Evan0825/feldspar/docs/design/review-decisions-20261029.md

# 月石逐页选稿记录 · 2026-10-29

来源：用户上传的确认汇总截图 `codex-clipboard-64d0b12b-cbe1-4e58-856b-c7799b330244.png`。这是直接反馈记录，不冒充服务端已提交回执。

## 已选18页

| 方案1 | 方案2 |
| --- | --- |
| p01登录、p04添加设备、p05连接网络、p06设备自检、p07月石首页、p09夜灯、p10助眠声音、p12七晚趋势、p13夜间事件、p19AI记忆、p20我的、p21AI与数据授权、p22实时状态、p23设备与家庭 | p02个性化偏好、p17今晚方案、p18对话记录、p24今晚设置 |

## 待确认6页

| 页面 | 用户意见 | 本轮处理 |
| --- | --- | --- |
| p03隐私与数据 | 保持原样或按照推荐 | 说明与读取权限分开，一次明确确认 |
| p08温和方案 | 阶段介绍太长，两套都不喜欢 | 当前阶段和真实进度优先；四阶段短标签或按需展开 |
| p11单晚睡眠 | 方案2较好，图表详情是否二级进入 | 保留简洁首屏，接通数据详情、图表、质量、体位关联和事件 |
| p14晨间反馈 | 两套需要结合 | 同屏三个短问题；逐题版支持返回和提交前汇总 |
| p15AI首页 | 需多个联动交互后判断 | 接通报告、依据、问题、建议、确认和历史演示 |
| p16AI对话 | 同上 | 支持追问、原夜晚回看、建议独立确认后返回对话 |

整体意见：未确认页面下一轮确认；页面过于模糊，须优化，不允许沿用。

## 清晰度和素材约束

- 文字、图表与控件直接渲染；每页独立导出1170×2532，不把多屏总览裁成小图后放大。
- 评审默认以390px以内展示，原尺寸放大有真实高分辨率像素。
- 所有产品大图共用 `design/assets/moonstone-system-natural-light-hd-cutout.png`，逻辑尺寸320×190；夜灯只叠加暖光效果，不改变产品图本身。
- 浏览器联动是本地设计演示，示例数据与模拟回读明确标注，不代替原生小程序或真实设备验收。
- 保留旧评审草稿键和用户选择；版本更新后不沿用旧回执。允许提交已确认部分，未选6页保持待确认。

本轮未修改小程序业务文件。下一步以待确认页面的选择推进原生实现，既定18页选稿方向不重开选择。

## 后续执行授权与定稿

用户随后明确要求：剩余6页按推荐完成，直接执行、不再询问。以上「待确认」为历史状态；本次采用 p03一次隐私确认、p08当前阶段优先且完整阶段折叠、p11简洁首屏与二级数据、p14同屏短表单、p15来源明确的精简AI入口、p16可追问并独立应用建议。

原生业务已更新上述6页及必要的数据详情、建议依据折叠；新增 `pages/report-detail/index`。浏览器完整推荐方案只提供一套组合，不再要求逐页选择。来源记录、AI授权、偏好限制、设备确认与历史保存沿用既有服务边界。旧评审草稿和回执不被伪造成新的提交。
