Evan0825/feldspar/docs/design/ui-assets.md

# 月石界面素材

- `moonstone-ui-v1-sleep-home.png`、`moonstone-ui-v1-sleep-detail.png` 为 [现行设计规范](../ui-style-preferences.md) 的方案 5 定稿参考图，采用同一晚的示例数据，独立导出 1170×2532。
- `moonstone-ui-approved-20261028.png` 为上一轮选稿的四屏设计存档。
- 原生 `images/ui/` 的 Lucide 图标与 `images/ai-ui/` 图标由项目使用的 `lucide-react` 1.37.0 栅格化，遵循所附 ISC 许可。`images/ui/` 也包含 Material Icons，Apache-2.0 许可随目录提供。
- 设备主图、紧凑设备图和夜灯缩略图：复用本项目已有设备图片，没有新增第三方照片。
- 原生实屏来自微信开发者工具，单独保存到验证目录；不得把生成稿当作硬件运行效果证据。
