Evan0825/feldspar/COLLABORATION.md

# 共同维护

仓库地址：https://github.com/Evan0825/feldspar ，私有。后续可迁移至免费组织 feldspar-sleep。每人使用自己的 GitHub 账号；由仓库负责人邀请指定好友共同维护，不共享账号或密钥。协作者邀请对象为 Fu99966；邀请是否接受以 GitHub 显示为准。

1. 克隆仓库，按 README 安装依赖并运行离线检查。
2. 每个修改使用独立分支，通过 Pull Request 说明变更与验证结果；保留 review 讨论。
3. 凭据、设备密钥、私人录音与睡眠数据保留本地；使用配置模板接入各自测试环境。
4. 固件协议/输出改动需对应构建及实机验收；未完成数据评估和物理标定前保持自动干预关闭。

GitHub Free 私有仓库可使用 Issue/PR 协作；是否强制审核或保护分支以套餐支持为准，不把尚未配置的保护规则描述为已经启用。
