Evan0825/feldspar/docs/materials/snoring-model-training-report.html

本报告记录 2026 年 9 月的 v5 鼾声模型研究。模型尚未集成到 V6 公开固件。报告原创内容采用 CC BY-NC 4.0 (https://creativecommons.org/licenses/by-nc/4.0/deed.zh-hans)，非商业教学与科研可免费使用，商用须另行授权。

SnoozMate · 酣眠 · 端侧鼾声识别模型 · 训练与验证报告 · 2026-09-05

# 床头主机上的鼾声识别模型：从数据到可发布固件

酣眠的床头主机（ESP32-S3，双麦克风）需要在本地实时识别连续鼾声、判断鼾声来自床的哪一侧，并把结构化事件而不是录音交给云端。本报告说明这个模型是怎样训练出来的：数据如何清洗与隔离、标签如何核验、网络如何选型与校准、结果如何在测试集、整夜流式基准与方向仿真中验证，以及模型如何带着完整的可追溯性交付到固件。

床头柜上的月石卧舱亮着琥珀夜灯，用户在床上熟睡

交付物int8 模型 34,336 B · C 参考实现 · 模型卡

代码v5/ Python 包 · esp32_firmware/v5/ · 130 项测试

结果测试半 AUC 0.998 · 跨集合 AUC 0.80

代码仓库snoring-ml-training · v5 流水线

## 1目标与交付概览

产品逻辑是先正确识别，再正确归属，最后才是可停止的渐进干预：端侧运行一个小型蒸馏模型加多模态规则，安全由确定性状态机裁决，云端只做跨夜总结。因此训练工作的目标不是"一个准确率数字"，而是一条能烧进 ESP32-S3、能连续运行一整夜、能说明自己有多可信的识别链路。下表列出产品需要的每一项能力与对应的实现。

产品需求 | 实现方式 | 状态
0.5–1 米床头鼾声初筛，端侧蒸馏模型（ESP32-S3） | 冻结特征规格 v1，25,745 参数卷积网络，int8 TFLite 34 KB，C 特征提取与黄金向量逐值对齐 | 已实现
连续、周期性鼾声才算数，排除偶发声响 | 整数节拍状态机：至少 3 次爆发、周期 1.5–7 s、10 s 确认窗；Python 与 C 双实现，702 拍零差异 | 已实现
鼾声停止即时撤出，可记录响应时间 | 活跃标志逐拍输出，15 s 无活动结束片段并给出时长、均值置信度与声级 | 已实现
声源方向：只提醒打鼾者一侧 | 双麦 GCC-PHAT，带限 60–3000 Hz，噪声底跟踪，片段级直方图聚合；仿真在 0.06 m 麦距、≤1 m、SNR ≥5 dB 时侧别准确率 ≥0.94 | 已实现
两个人都可能打鼾时不自动干预 | 双方判定规则：两侧有效帧都超过比例阈值时返回 both，交由固件转为只记录 | 已实现
在床、体动、翻身（毫米波雷达） | 边缘事件结构预留 radar_presence / radar_motion / radar_breath_rate 字段；云端载荷只在雷达确有观测时携带，不凭空生成"在床" | 字段预留，无数据
仰卧 / 侧卧趋势 | 需要声学体位数据集（SSBPR，需向作者申请）；本轮未实现 | 未实现
渐进提醒、冷却、温度、次数等安全上限 | 属于固件确定性状态机与云端 SAFETY_LIMITS；本项目只输出"确认中且活跃"的信号，不触碰执行权 | 范围外
记录结果，上传的是事件而不是整夜录音 | edge_event_v1 事件结构，转换为云端 EventIn；备注 JSON 不超过 1000 字符，无原始音频 | 已实现
七晚学习、晨报、伴侣净收益 | 云端仓库已有 bandit 参数调优与晨间解读；本项目提供其输入事件 | 云端已有
演示与评估中模拟数据必须与真实数据可区分 | 模型版本禁止含 simulator / demo / mock；模型卡区分测试集、跨集合与合成基准，并记录每一次测试集重置的原因 | 已实现
用真实床头的自录数据持续改进模型 | 床头采集脚本 + 标注模板 + 微调脚本；候选模型通过 import-candidate 与 final --run 走同一套校验与校准 | 已实现，待数据

一句话结论。识别链路已经完整：麦克风窗口进来，1 秒后给出概率，状态机把概率变成"连续鼾声片段"，方向模块给出左右，事件按云端格式上传。链路里每一个数字都能追溯到具体的数据划分与模型哈希。真正的短板不在代码而在数据：可用的、经核验的真实鼾声只有约 550 个训练窗口，因此模型在陌生录音环境上的召回率明显低于同源测试集，下文会用数据说明这一点。

## 2端侧系统结构

系统分为三层：实时判断在本地，长期学习在云端，安全交给确定性状态机。本项目实现的是本地层里"听"的那一半，并把结果以事件形式交给云端层。图 1 是月石主机里从麦克风到事件的数据流；灰色部分是固件与云端已有或待实现的模块。

图 1 端侧识别链路。本项目交付的是白色节点：特征提取、模型、片段状态机、方向判定与事件结构。安全状态机与振动片控制留在固件，云端只收到事件。

月石卧舱、手机小程序与枕下定向振动片

训练侧对应的流水线如图 2。它刻意做成一条只能按顺序走、每一步都会拒绝错误输入的链：清单确定数据划分，教师模型核验标签，训练只在训练与验证集上选型，校准集单独决定阈值，测试集只由导出器读取一次，模型卡最后把所有报告的哈希对上。

图 2 训练与发布流水线。每一步的产物都记录上一步产物的 SHA-256；任何一步的输入若不属于当前发布，后续命令直接拒绝。

## 3数据：来源、去重、隔离划分

训练目录里有五组数据：WHLTalent 的"鼾声 / 环境"批次，Kaggle 上的两份鼾声集（adrianagaler 与 jibran），ESC-50 环境声（含 40 段打鼾），以及 MS-SNSD 的房间噪声。全部重采样到 16 kHz，按来源规则切成 1 秒窗口：鼾声文件取能量峰附近的窗口，环境文件取最响处与随机处各一个，一共解码 12,874 个窗口。

切片之后先做两层去重。逐窗口 MD5 找出 14 个完全相同的波形；再用特征余弦相似度 ≥0.98 聚出 766 个近重复簇。最重要的发现是：adrianagaler 与 jibran 有 745 个簇互相重叠，它们其实是同一份数据的两个副本。上一代 v4 把两者随机混进训练与测试，97.3% 的准确率就是这样被抬高的。

v5 的划分规则因此以"簇"和"录音组"为最小单位，任何一组只能落在一个分区：

- train：训练；val：只用于选型；calib：只用于定阈值；
- test：Kaggle 按簇对半切出的那一半，只有导出器读，且只读一次；
- bench：WHLTalent 批次 000002 的一半录音与两成 MS-SNSD 噪声，只给整夜基准与方向仿真用；
- drop：因去重、分区冲突或审计被剔除的窗口，理由逐条写入 drop_provenance.json。

trainvalcalibtest（只读一次）benchdrop

图 3 各来源窗口的最终去向（来自 manifest_report.md）。Kaggle 两份副本各自一半进入只读测试集；WHLTalent 的"鼾声"批次绝大部分被审计剔除，原因见第 4 节。

划分完成后还有一组不变量检查会让构建直接失败：同一录音组或同一近重复簇跨分区、测试集与训练集共享簇、任一分区样本数低于配置下限（如训练正样本 ≥400、校准负样本 ≥300）。生成的数据代先写到暂存目录，全部检查通过后再整体替换，回滚时连没有备份的新文件也会删除。

## 4教师审计：为什么要先质疑标签

第一次训练的验证 AUC 只有 0.74，排查后发现问题不在模型而在标签。用 YAMNet（Google 的 521 类音频事件模型）给每个非测试窗口打分，把"打鼾 + 喷鼻息"两类概率加起来看，WHLTalent 批次 000000 的"鼾声"窗口中只有 9% 被听成鼾声；这些录音是 −55 dBFS 的低频隆隆声，60 Hz 以下能量占主导。用它们训练的模型在真正可听的批次 000002 上 AUC 只有 0.15–0.34，也就是反向迁移。

于是把教师审计做成流水线里不可跳过的一步：概率低于 0.1 的正样本按"未核验"剔除，概率高于 0.5 的负样本按"混入鼾声"剔除；训练命令若发现清单没有经过审计会直接报错。审计只作用于训练、验证、校准与基准分区，测试集从不打分。

图 4 审计剔除的窗口数（按理由与来源）。批次 000000 的 1,844 个"鼾声"窗口被整体判为不可信；Kaggle 两份副本各剔除约 80 个，ESC-50 的打鼾片段也有 35 个不含可辨鼾声。审计后剩下 551 个经核验的训练正样本。

教师文件本身也被纳入追溯：teacher.csv 每行带窗口 MD5，teacher_meta.json 记录缓存指纹、教师标识与阈值；审计时若指纹或任一 MD5 对不上就拒绝应用，训练前再核对一次审计时记录的文件哈希。这样教师分数永远不会被套用到另一批音频上。

## 5特征规格与学生网络

端侧模型能不能用，首先取决于训练时的特征和固件里算出来的特征是不是同一个东西。v5 把特征规格冻结为版本 1，Python 参考实现与 C 实现共用同一份常数头文件与同一组黄金向量：

输入

16 kHz，1 秒窗口（16,000 个 int16 样本），流式每 8,000 样本推进一次

频谱

512 点 FFT，帧移 256，周期性 Hann 窗，得到 61 帧

滤波器组

30 个 HTK mel 三角滤波器，40–6000 Hz

压缩

L = 10·log10(mel + 1e-10)；X = clip((L − mean(L)) / 40, −1, 1)，逐窗去均值使模型对增益不敏感

量化

按转换器给出的 scale / zero-point 映射到 int8（本次为 0.007843，−1）

图 5a 一个经核验的训练鼾声窗口（Kaggle 训练半）的 61 × 30 特征图。横轴为时间帧，纵轴为 mel 频带，低频带的周期性能量团是鼾声的典型形态。

图 5b 一个 MS-SNSD 房间噪声窗口的特征图，能量在时间上平坦、在频率上分散。

学生网络刻意很小：三层 3×3 卷积（16 / 32 / 64 通道，各带 BatchNorm、ReLU 与 2×2 最大池化），全局平均池化，32 维全连接，输出一个 logit。共 25,745 个参数，量化后 34,336 字节，算子只有 CONV_2D、MAX_POOL_2D、MEAN、FULLY_CONNECTED、LOGISTIC 五种，激活区估计 60.6 KB。这个规模在 ESP32-S3 上每 0.5 秒推理一次绰绰有余。

图 6 学生网络结构。宽度 2.0 的变体把每层通道数翻倍（101,665 参数），用于选型对比。

训练时的增强直接对应床头场景：用镜像法生成的房间冲激响应（按直达声峰值归一化）模拟 0.5–1.5 米距离；从 MS-SNSD 与 ESC-50 训练负样本中抽噪声按信噪比混合；再加频谱倾斜、时移、增益与 SpecAugment 遮挡。每个样本的随机数由 (种子, 轮次, 批次, 槽位) 决定，任何一次训练都能逐样本复现。

## 6训练矩阵与选型

选型只看验证集，且必须跑完固定的四组实验：硬标签 / 知识蒸馏 × 宽度 1.0 / 2.0。蒸馏把 YAMNet 的分数经 Platt 校准后作为软目标，与硬标签按 0.5 混合。选型规则写在配置里：在 AUC 距最优 0.005 以内且 2% 误报率下召回距最优 2 个点以内的实验中取参数最少者；若没有实验同时满足，则在 AUC 近最优者中取召回最高者。

图 7 四组实验在验证集上的 AUC 与 2% 误报率下的召回。hard_w1 是唯一 AUC 落在最优 0.005 以内的实验，被选中；蒸馏与加宽都没有带来收益，说明瓶颈在数据量而不是模型容量。

每次训练都把清单哈希、验证集样本哈希、模型文件哈希与审计状态写进 metrics.json。选型命令会核对四组实验的名称与 (蒸馏, 宽度) 配置一一对应、验证集完全相同、模型文件未被改动，否则拒绝选型。

## 7阈值校准：把误报率钉在 1%

产品对误触发的容忍度很低，因为每一次误触发都是一次对伴侣的打扰。阈值 τ 不由验证集决定，而是在独立的校准集上按"负样本误报率 ≤1%"直接推导：取排序后允许越过的负样本顺序统计量，τ 是严格高于它的最小 float32 值。固件比较的是 float32 概率，因此 τ 必须本身就是 float32 可精确表示的数，头文件用 9 位有效数字输出，与 JSON、指标、基准共用同一个值。

图 8 校准集上的模型分数分布（1,013 个负样本，17 个正样本）与最终阈值 τ = 0.80605。负样本中恰有 10 个越过 τ（0.99%，Clopper-Pearson 95% 上界 1.67%）；正样本仅 17 个，召回 9/17，这也是该阈值偏保守的原因。

若校准负样本不足 300 个、没有阈值能满足误报率目标、或阈值下没有任何正样本通过，校准会直接失败并拒绝部署，而不是退回某个默认值。

## 8测试集只读一次：结果与鲁棒性

测试集是 Kaggle 按簇切出的另一半，998 个窗口，其中 514 个鼾声。它被设计成"只有导出器能读，而且一个模型只能读一次"：导出时先在 test_consumption.json 里登记模型、清单、τ 与评估包每个文件的哈希，再做评估；之后同一模型重复导出直接复用评估包，换模型、换清单、换 τ 都会被拒绝。要再评估必须执行带理由的重置命令，理由写入台账并印在模型卡上。本次发布的台账里有两条记录：一次是修复导出与增强代码后的重置，一次是把 τ 改为 float32 精确值后的重置。

模型路径 | AUC | 召回 @2% 误报 | 精确率 @τ | 召回 @τ | 误报率 @τ
float（训练模型） | 0.9978 | 0.984 | 0.996 | 0.961 | 0.004
int8（部署路径） | 0.9977 | 0.984 | 0.996 | 0.963 | 0.004

int8 与 float 的一致性门禁：AUC 差 0.0001（上限 0.005），逐窗决策一致率 99.9%（下限 99%），概率最大偏差 0.028（上限 0.05）。三项任一不满足，导出失败。

召回 @τ召回 @2% 误报

图 9 测试集上的鲁棒性扫描：叠加 MS-SNSD 噪声到不同信噪比，或卷积 0.5 / 1.0 / 1.5 米的房间冲激响应。柱上数字为该条件下的 AUC。信噪比降到 5 dB 时阈值下召回降到 0.79，1.5 米时降到 0.70，说明距离和噪声是端侧部署的主要敏感因素。

同源测试集不等于真实床头。测试半与训练半来自同一批 Kaggle 录音，AUC 0.998 说明模型学会了这批录音里的鼾声，不说明它见过所有鼾声。把同一个模型放到从未参与训练的 WHLTalent 批次 000002 上：验证材料 AUC 0.805、阈值下召回 0.19；基准材料 AUC 0.793、召回 0.12。这一差距是本次交付最重要的事实，第 15 节讨论怎么补。

## 9一晚闭环：连续鼾声状态机

只有持续、周期性的鼾声才应触发提醒，偶发声响要被排除；鼾声一停，提醒必须立即撤出。这两条都由一个整数节拍的状态机实现，节拍 500 ms，与模型推理同频。状态机只消费概率与声级，不做任何浮点累加以外的运算，因此 Python 参考与 C 实现可以逐拍对齐。

图 10 片段状态机。"活跃"是 6 秒保持窗内的最大概率是否越过 τ，供固件在确认期间驱动振动；"爆发"是连续命中的起点，周期性由爆发间隔的下中位数判断。

01

#### 持续感知

每 0.5 s 一个概率。低于 τ 的窗口不产生任何状态变化，偶发声响最多让状态短暂进入 ACTIVE。

02

#### 交叉确认（本项目的部分）

至少三次爆发、间隔落在人的呼吸周期内（1.5–7 s）、累计活跃达到 10 s，才进入 CONFIRMED。固件在此基础上再叠加在床与体位条件。

03

#### 渐进提醒

状态机只提供"确认中且活跃"的布尔量，强度、次数与冷却由固件安全状态机裁决。

04

#### 即时停止

活跃标志随最近 6 s 的概率变化，鼾声停止后 6 s 内清零；片段在 15 s 无活跃后收尾，避免呼吸间歇被切成多个片段。

05

#### 记录结果

片段结束输出起止拍、时长、均值置信度、爆发数、平均声级与片段编号，供事件结构与云端摘要使用。

为了衡量整条链路而不只是单个窗口，构建了合成整夜基准：以 bench 分区的 MS-SNSD 噪声作床，随机插入 bench 分区的鼾声片段与非鼾声干扰音，按 0 / 5 / 10 / 20 dB 生成 20 个一小时的夜晚，事件与真值一对一匹配。

floatint8（部署路径）

图 11 合成整夜基准。左：被状态机确认的鼾声片段比例；右：每小时误确认次数。int8 与 float 逐拍决策一致率 99.96%。片段确认率偏低（4%–29%）直接对应第 8 节中跨集合召回率 0.12–0.19 的事实：鼾声素材来自从未训练过的 WHLTalent 批次 000002。

## 10声源方向：只提醒打鼾者一侧

共睡模式的前提是知道鼾声来自床的哪一侧。月石有两只麦克风，实现采用 GCC-PHAT（相位变换广义互相关）：对每帧 512 点做 FFT，取右麦与左麦共轭乘积并做幅度归一，只保留 60–3000 Hz，逆变换后在 ±最大时延（麦距 0.06 m 对应 ±4 个样本）内找峰，并用抛物线插值得到亚样本时延。正时延表示声音先到左麦，即声源在左侧。

三条规则决定一帧是否可信：峰值必须至少是其余所有时延处最大相关值的 1.5 倍；带内能量至少占全帧的 5%（否则是带外噪声）；帧声级必须高于自适应噪声底 6 dB，噪声底对安静帧快速下降、对不相干的响帧缓慢上升、对相干帧从不上升。可信帧的时延进入 0.01 样本分辨率的直方图，片段结束时取下中位数得到方向，左右计数比给出置信度。片段可以无限长，内存固定。

图 12 pyroomacoustics 仿真：在 4 m × 3.5 m 房间中把 bench 分区的鼾声放在床两侧不同距离与方位，每格 50 次试验，格内数字为侧别判定准确率。产品默认麦距 0.06 m（高亮行）在 ≤1 m、SNR ≥5 dB 时准确率 0.94–1.00；1.5 m 且 0 dB 时降到 0.66，此时 32% 的片段被判为"未知"而不是猜错。

当左右两侧的可信帧都超过设定比例时，片段被标为 both，对应产品规则：两个人都可能打鼾时，第一版不自动干预，只记录并提示分别建立单人基线。C 实现提供 int16 入口（doa_gcc_phat_i16、doa_tracker_frame_i16）和每个片段开始时调用的重置函数：重置清空投票但保留噪声底，主机测试用 5,500 帧的长片段与镜像片段验证了这一点。

## 11事件而不是录音：云端载荷

设计原则是上传事件，而不是整夜录音。端侧事件结构 edge_event_v1 包含时间戳、鼾声概率、状态机状态、片段编号、方向与置信度、声级，以及为雷达预留的在床、体动、呼吸率字段；温度门控与振动等级字段用于日志回盘。转换到云端 EventIn 时：

{
  "device_id": "moonstone_01", "timestamp": 1757000000,
  "event_type": "snore_detected",
  "snore_duration_sec": 42.5,          // 片段时长
  "snore_confidence": 0.87,            // 片段内命中窗口的平均概率
  "in_bed": true,                      // 仅当雷达确有观测时才出现
  "body_motion_level": 0.3,            // 同上；没有雷达时两个字段都省略
  "model_version": "cnn_v5_int8",      // 禁止含 simulator / demo / mock
  "note": "{\"side\":\"left\",\"lag_ms\":0.12,\"doa_conf\":0.8,\"n_bursts\":11,\"level_dbfs\":-38.2}"
}

备注 JSON 不超过云端限制的 1000 字符；模型版本若含模拟数据的标记会在转换时抛错。云端据此计算夜间摘要，晨报把"哪一侧、持续多久、多少次"讲给两个人听。

## 12导出、发布门禁与可追溯性

导出命令做的事情很多，但原则只有一条：任何门禁失败，交付目录一个字节都不变。转换、评估与头文件生成都在暂存目录完成，全部通过后与固件头文件目录一起原子替换，失败则回滚到上一发布。

图 13 发布门禁顺序。测试集的读取发生在门禁链中间，读取前已确认模型与阈值属于当前清单。

模型卡是最后一道校验。它要求基准与方向报告的绑定信息（模型、TFLite、清单哈希，τ，状态机参数，基准夜数与信噪比，方向扫描的麦距、距离、试验次数）与本次导出完全一致，用生成器自己的渲染函数重新生成 Markdown 并逐字节比对，再从逐夜记录重算每个汇总指标。改过一个数字的报告进不了模型卡。

产物 | 绑定到 | 拒绝条件
runs/*/metrics.json | 清单哈希、验证集哈希、模型哈希、审计状态 | 清单重建或模型文件改动后不再参与选型
deployed/threshold.json | 模型哈希、清单哈希、验证集哈希 | 导出时与当前清单不符
test_consumption.json | 模型、清单、τ、评估包每个文件的 SHA-256 | 另一模型、另一清单、另一 τ、任一文件改动
benchmark_nights.json / doa_sim.json | 模型、TFLite、清单哈希，参数集合，Markdown 内容 | 任一项与 export_info.json 不同
teacher.csv / teacher_meta.json | 缓存指纹、逐窗 MD5、审计时的文件哈希 | 指纹或 MD5 不符即不能审计，哈希不符即不能训练

## 13C 参考实现与固件对接

工作台上的月石主机拆解件、ESP32-S3 开发板、扬声器与枕下振动片

固件工程师拿到的是四个 C99 源文件和一组生成头文件：fft512.c、snore_features.c、snore_episode_fsm.c、doa_gccphat.c，以及 model_data.c（TFLite 字节数组）、model_meta.h（量化参数、τ、状态机节拍）、feature_spec.h 与 mel_filterbank.h。工作缓冲全部为静态分配，不占任务栈，约定从单一任务调用。

window (int16[16000], hop 8000) -> sf_compute -> sf_quantize(INPUT_SCALE, INPUT_ZERO_POINT)
  -> TFLM invoke -> p = (out - OUTPUT_ZERO_POINT) * OUTPUT_SCALE -> fsm_tick(p, level_dbfs)
  -> 仅当 fsm.state == FSM_CONFIRMED && fsm.active 时允许振动
stereo frame (int16[512] × 2) -> doa_tracker_frame_i16 (片段开始时先 doa_tracker_reset_episode)
  -> 片段结束 doa_tracker_episode -> side / lag_ms / conf 写入事件备注

主机端对齐测试用 Python 生成的黄金向量驱动 C 代码：

测试 | 内容 | 结果
特征 | 12 个窗口（含 −60 dBFS 静音、满幅、测试集鼾声与噪声）的 int16 → 特征 → int8 | 最大偏差 2e-5，0 失败
状态机 | 702 拍发布参数轨迹 + 284 拍容量边界轨迹（confirm + hold + 1 = 64），逐拍比对状态、活跃、事件与片段字段，并核对保留的命中集合 | 0 差异
方向 | 整数与分数时延、静音、不相干噪声、带外 5 kHz 单音、5,500 帧含换边的长片段、重置后的镜像片段；float 与 int16 入口逐帧比对 | 0 失败

需要说明的边界：桌面 C 测试证明的是数值一致性，不是 ESP32-S3 上的可运行性。固件构建仍需确认 TFLite Micro 算子解析器包含上述五种算子、实测张量区大小（估计 60.6 KB）与 Flash 占用。

## 14自录数据与个人微调

公开数据集里的鼾声与真实床头 0.5–1 米处录到的声音并不相同，第 8 节的跨集合结果说明这一差距是当前最大的误差来源。为此交付了两样东西：

- 采集脚本 v5/recording/record_session.py：以 16 kHz 立体声从床头位置连续录制，按分钟分块写 WAV，附带标注模板（片段起止、是否鼾声、哪一侧、伴侣反馈）。
- 微调脚本 v5/finetune.py：以部署模型为起点，在自录会话上小学习率微调，留出一个会话做保留集；产物标记为 cnn_v5_ft_candidate_日期 且 deployable: false。

候选模型没有捷径：train import-candidate 在当前验证集上重新评估并登记哈希，train final --run 重新在校准集上定阈值，然后必须通过第 12 节的全部门禁。"永远不在设备端做无监督反向训练"的原则在这里体现为：微调只在训练侧、只用有标注的数据、只能通过同一条发布链。

## 15诚实的结论与下一步

评价这项工作的标准应当是"先证明适用，再持续服务"。按这个标准，本次工作证明了三件事，也暴露了一件事。

- 证明了链路可以跑通并且可信：从麦克风到事件的每一步都有 Python 参考、C 实现与逐值对齐测试，每一个数字都能追溯到清单与模型哈希。
- 证明了模型足够小、足够稳：34 KB、五种算子、int8 与 float 决策一致率 99.9%，20 dB 信噪比下测试召回 0.98。
- 证明了方向判定在产品麦距下可行：0.06 m、1 m 以内、SNR ≥5 dB 时侧别准确率 ≥0.94，且拿不准时会说"未知"。
- 暴露了数据的短板：经核验的真实鼾声训练窗口只有 551 个，模型在陌生录音环境上的召回率只有 0.12–0.19，整夜基准中只有 4%–29% 的片段被确认。这不是调参能解决的问题。

### 下一步（按收益排序）

1. 用第 14 节的采集脚本在真实床头录 3–7 晚，标注后微调；这是唯一能同时改善召回与方向可信度的事。
2. 补充经核验的公开鼾声音频（如 AudioSet 打鼾类），继续通过教师审计而不是直接信任标签。
3. 雷达在床 / 体动数据到位后，把预留字段变成真正的交叉确认条件。
4. 申请 SSBPR 数据集，评估声学体位（仰卧 / 侧卧）头是否值得做。
5. 固件侧两项小修补：fsm_init 与 doa_tracker_init 增加参数范围校验；主机测试检查内存分配结果。

本报告中的全部数字取自 output/v5/deliverables/ 下的模型卡、清单报告、实验记录、整夜基准与方向仿真结果，均由发布链在同一模型哈希（c0d3ac44…）与清单哈希（e7dd580f…）上生成。趋势观察，不是医疗诊断：本模型用于识别鼾声趋势，不替代睡眠监测、OSA 诊断或临床治疗。

snoring-ml-training · branch feat/v5-edge-pipeline · pull request #1 · 2026-09-05
