Evan0825/feldspar/hardware/v4/HAPTIC.md

# SnoozMate 枕下震动模块设计规格

## 目标

在现有“精致月石 V4 顶部按键最终版”材料包中增加一套独立的枕下震动模块。该模块将白色驱动模块和硬币震动马达封装在同一个低矮、圆润的双件式外壳内，通过有线方式连接床头月石主机。不改动现有月石主机六个打印件的几何形状。

## 已知硬件与设计假设

- 驱动模块根据用户提供的标尺图按 `24 × 35 × 10 mm` 设计。
- 驱动模块两个安装孔的标称孔径为 `4.8 mm`，孔中心距为 `16 mm`。
- 驱动模块的 CAD 保留包络为 `27 × 38 × 10.8 mm`，XY 方向每侧至少留 `1.5 mm`，高度留 `0.8 mm`。
- 硬币震动马达尚无精确实测值，本版使用 `Ø13 × 5 mm` 通用仓，适配直径 `10–12 mm`、厚度不超过 `4.5 mm` 的马达。
- 马达以 `0.5–1.0 mm` 泡棉胶或硬质双面胶固定。如实物超出通用范围，不强行压入，需按实测尺寸重新生成马达仓。
- 线材或插头最宽尺寸尚未实测，本版采用合盖后形成的 `8 × 4 mm` 侧向出线口，线材在合盖前从开口放入，不要让完整插头穿过出线口。

## 方案选择

采用“驱动模块和马达同壳封装”方案。不采用驱动模块裸露安装，因为裸露模块会形成局部硬点，也更容易受到枕头反复压力和线材拉扯。不采用独立驱动小盒，以避免增加第二个硬块和中间连接线。

## 外形与打印件

新增两个可打印 STL：

1. `snoozmate_refined_v4_final_haptic_lower.stl`：枕下震动模块下壳，包含马达仓、驱动模块安装位、走线槽、防拉扯位和合盖螺丝孔。
2. `snoozmate_refined_v4_final_haptic_lid.stl`：圆润上盖，内侧带驱动模块限位面和合盖固定柱。

组装后外形包络为 `75 × 55 × 14 mm`。平面轮廓为不对称卵石形，四周连续圆润；上表面是低拱形，底面近似平面以提高震动传递效率。外部不设计裸露立柱、棱角或高于外表面的螺丝头。

下壳底部标称壁厚 `1.6 mm`，上盖最小壁厚 `1.6 mm`，内部有效高度至少 `10.8 mm`。上下壳接缝采用内外止口定位，标称单边间隙 `0.25 mm`。

## 内部布局

- 马达仓位于底板几何中心附近，马达的平面紧贴下壳底板，不在马达和底板之间放置厚软垫。
- 驱动模块沿 `75 mm` 长轴方向布置在马达仓旁，避免与马达仓及出线口重叠。
- 驱动模块上下各使用 `0.4 mm` EVA 或 TPU 缓冲片，合计 `0.8 mm` 高度余量；下垫减少模块长期直接承受震动冲击，上垫提供轻微预压。
- 驱动模块两孔按 `16 mm` 中心距排列。下壳设置两根 `Ø4.4 mm` 圆头定位柱，穿入标称 `Ø4.8 mm` 安装孔；上盖内侧以 `0.4 mm` EVA/TPU 软垫限位。该结构不使用会占用高度的 M4 螺钉头，驱动模块可通过拆盖维护。
- 马达线和驱动模块线使用宽 `3 mm`、深 `2 mm` 的内部走线槽，转弯处半径不小于 `2 mm`。

## 出线与防拉扯

出线口位于 `75 mm` 长轴一端，上下壳各提供半高开口，合盖后形成 `8 × 4 mm` 通道。通道内缘圆角不小于 `R1 mm`。出线口内侧设两道错位压线肋，线材以波浪路径通过，拉力不直接传到驱动模块插座或焊点。对于直径小于 `3 mm` 的线材，在出线口内增加 TPU 胶套或热缩管补偿间隙。

## 合盖和紧固

上下壳四周设四个 M2.5 内部承力柱。下壳底面使用四个不突出底面的沉头或沉孔螺丝位，螺丝锁入上盖内侧的 M2.5 热熔螺母柱。螺丝头顶面至少低于底面 `0.2 mm`，可用 `0.5 mm` 薄型硅胶圆点覆盖孔位。

设计不依赖纯卡扣作为唯一闭合方式，以避免反复震动下卡扣松脱。止口负责对位，四颗 M2.5 螺丝负责预紧。

## 材料和打印

- 原型优先使用 PLA+，需要更好抗摔性时使用 PETG。
- 喷嘴 `0.4 mm`，层高 `0.16–0.20 mm`，4 道壁，顶底至少 5 层，填充 `20–25% Gyroid`。
- 下壳底面朝下平放打印；上盖外观面朝上、开口朝下打印。
- 圆角、内部压线肋和柱体尽量使用不大于 `45°` 的自支撑轮廓；如切片器判定出线口或上盖固定柱需支撑，使用仅接触平台的树状支撑。

## 装配顺序

1. 先用实物检查驱动模块外形、孔径、孔距和最高点，试套两根定位柱；定位柱只负责定位，不得胀紧或顶弯模块。
2. 将硬币马达粘在下壳中心马达仓，导线放入 `3 × 2 mm` 走线槽。
3. 铺设底部 `0.4 mm` 缓冲片并安装驱动模块，在上盖对应区域贴顶部 `0.4 mm` 缓冲片；确认两片软垫与模块合计不超过 `10.8 mm` 保留高度。
4. 连接马达和主机线，将对外线材压入防拉扯肋和 `8 × 4 mm` 出线口。
5. 短时通电确认马达方向和震感，断电后合上上盖。
6. 交叉均匀锁紧四颗 M2.5 螺丝，不要过度挤压驱动模块。

## 代码和材料包变更

- 在 `cad/snoozmate_moonstone/` 中增加独立的枕下震动模块几何生成单元，避免把新外壳细节继续堆入现有月石主机函数。
- `refined_v4_final` 变体的可打印件数量从 6 个增加为 8 个。
- 更新模型验证脚本的期望数量、最大包络和枕下模块单独尺寸检查。
- 更新 V4 打印与装配说明、公差表、验证报告、预览图和最终 ZIP。
- 最终 ZIP 中保留现有月石主机全部文件，新增两个枕下震动模块 STL 和对应说明，不恢复已清理的旧版本材料。

## 验收标准

1. 枕下模块组装包络不超过 `75.0 × 55.0 × 14.0 mm`。
2. 驱动模块 `27 × 38 × 10.8 mm` 保留包络不与壳体、马达仓、螺丝柱或出线肋干涉。
3. 两根驱动模块定位柱直径为 `Ø4.4 mm`、中心距为 `16.0 mm`，对应标称 `Ø4.8 mm` 实物孔。
4. `Ø13 × 5 mm` 马达仓、`3 × 2 mm` 走线槽和 `8 × 4 mm` 出线口都是真实几何结构。
5. 上下壳止口的标称单边间隙为 `0.25 mm`，合盖螺丝头不高于底面。
6. 两个新 STL 都是封闭流形网格，无无效坐标、开放边和非流形边。
7. 现有月石主机六个 STL 与本次变更前的最终版逐字节一致。
8. 自动化几何测试、八件 STL 验证、ZIP 完整性和包内文件一致性检查全部通过。

## 安全边界

本项目只提供机械安装结构，不替代驱动模块厂商的电气、温升和负载规范。首次使用前需在无人压住的情况下进行短时震动和温升测试；如驱动模块、线材或外壳出现明显发热、异味、松动或异常声响，立即停止使用。
