Evan0825/feldspar/hardware/v4/tolerances.csv

位置 | 实物或标称尺寸_mm | CAD预留_mm | 装配余量
白色按键帽 | 直径13.0 | 直径14.6 | 单边0.8
DFR0029按键板 | 30x22 | 32x24x20 | XY单边1.0
按键板固定 | M2.5 | 内侧直径7.6正圆柱、自由端R0.8圆角、根部R3.2圆角扩展至直径14与直径3.4热熔螺母盲孔 | 盲孔直径含装配余量
底部喇叭 | 直径14.8x3.8 | 直径15.8x4.8 | 径向单边0.5高度1.0
喇叭出声与出线 | 底部出声 | 直径12.8出声孔加3x2出线缺口 | 四周约1.0承托边
声学脚托 | 底部四点支撑 | 顶部直径12底部直径10x高3.5 | 喇叭孔离桌3.5柔光环离桌1.3
总控板 | 63.4x28.3x5.2 | 68x33x20 | 长单边2.3宽单边2.35
后接口嵌片 | 46x1.8x8 | 45.6x1.6x7.4 | 宽深单边0.2高单边0.3
柔光环与底面 | 151x121 | 145x115 | 每边3.0
上壳与底座 | 上盖外形170x140 | 底座上沿170x140加163.8x133.8x1.2内插定位边 | 定位边相对上盖内腔单边约0.7
月石到枕下垫片电源线 | 按实物线径复核 | 后侧24x10x2.2压线桥加双侧支撑 | 建议2到4芯软线并保留弯折余量
枕下震动外壳 | 75x55x14 | 75x55x14 | 圆润双件外壳
震动驱动模块 | 24x35x10 | 38x27x10.8 | XY单边至少1.5高度合计0.8
驱动板定位孔 | 孔径4.8孔距16 | 定位柱直径4.4孔距16 | 直径间隙0.4
硬币震动马达 | 直径10到12厚度不超过4.5 | 直径13x深5 | 径向至少0.5高度至少0.5
马达与模块走线 | 线径按实物复核 | 3x2走线槽 | 转弯半径不小于2
枕下模块出线口 | 完整插头不穿孔 | 8x4合盖通道 | 内缘R1并带防拉扯肋
枕下模块止口 | 双件装配 | 单边0.25 | 先试合再锁M2.5螺丝
