Evan0825/feldspar/docs/design/moonstone-ui-v1-sleep-home.png

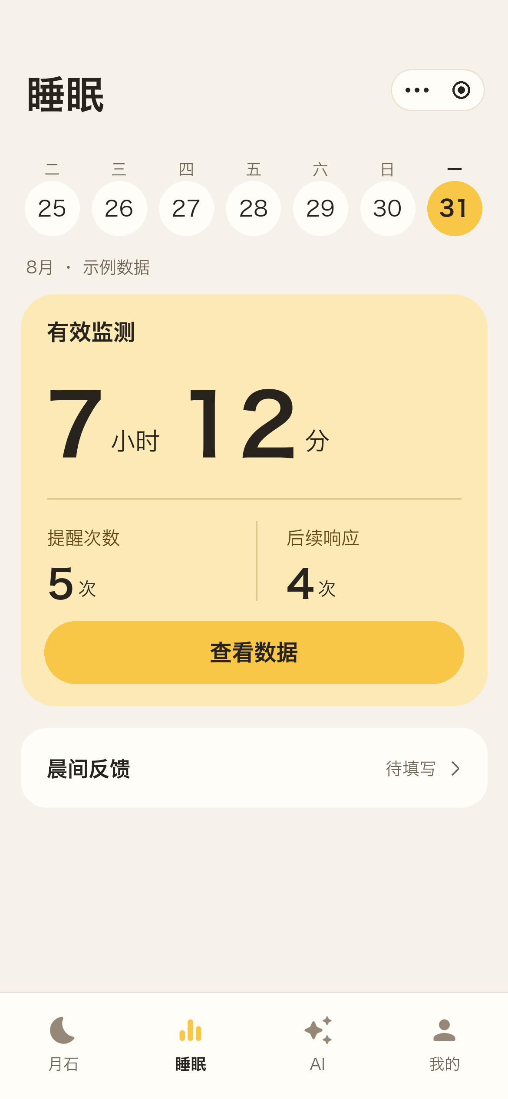
docs/design/moonstone-ui-v1-sleep-home.png
