Evan0825/feldspar/docs/materials/poster-black.png

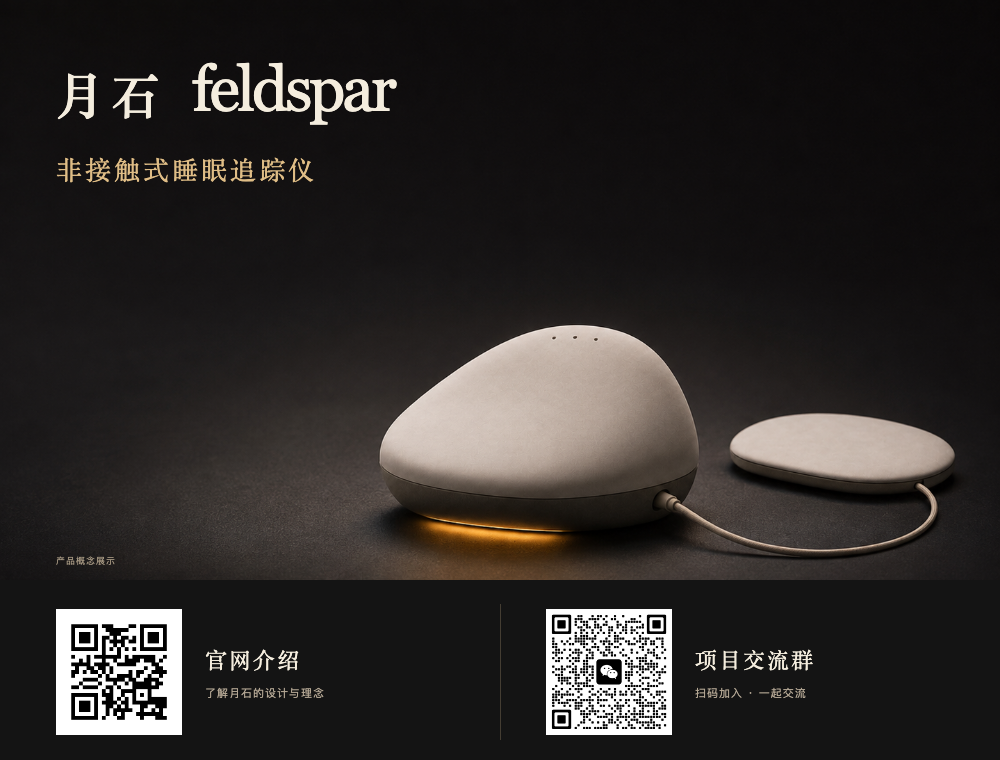
docs/materials/poster-black.png
