Evan0825/feldspar/docs/materials/poster-bleed.png

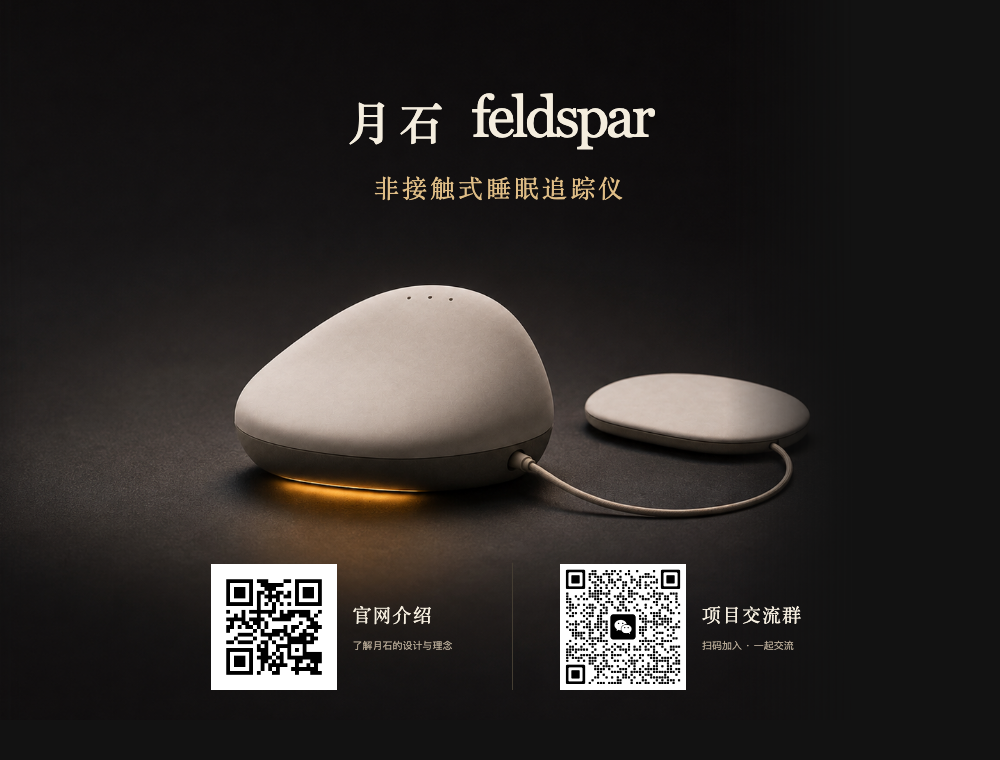
docs/materials/poster-bleed.png
