Evan0825/feldspar/docs/materials/poster-warm-white.png

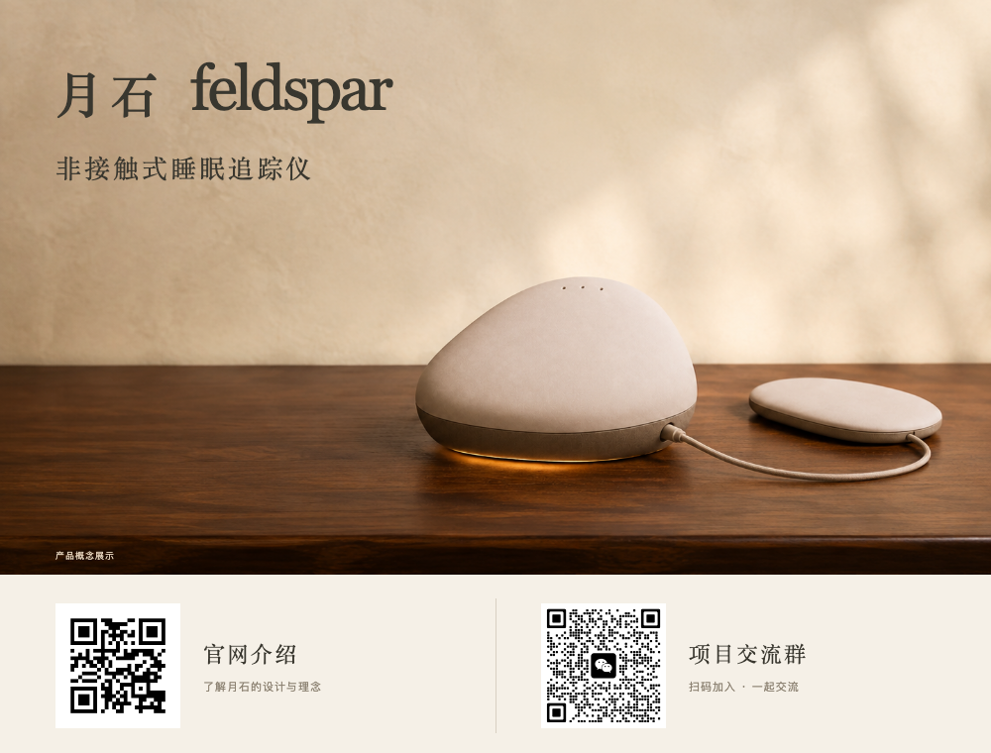
docs/materials/poster-warm-white.png
