Evan0825/feldspar/firmware/miniprogram-latest/images/host-detail.png

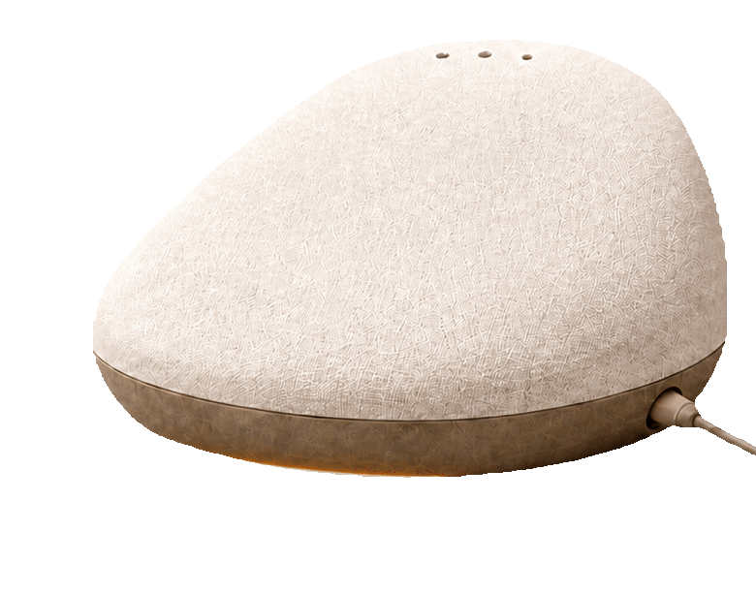
firmware/miniprogram-latest/images/host-detail.png
