Evan0825/feldspar/firmware/miniprogram-latest/images/status-check-outline.png

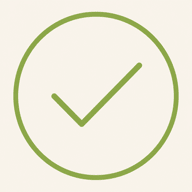
firmware/miniprogram-latest/images/status-check-outline.png
