Evan0825/feldspar/firmware/miniprogram-latest/images/status-ready.png

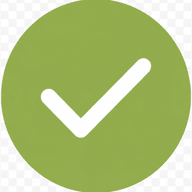
firmware/miniprogram-latest/images/status-ready.png
