Evan0825/feldspar/firmware/miniprogram-latest/images/system-compact.png

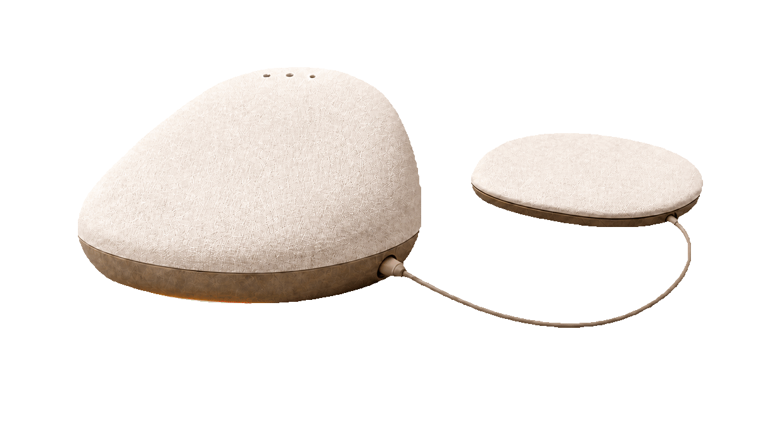
firmware/miniprogram-latest/images/system-compact.png
