Evan0825/feldspar/validation/ui-20261028/design-comparison-approved.png

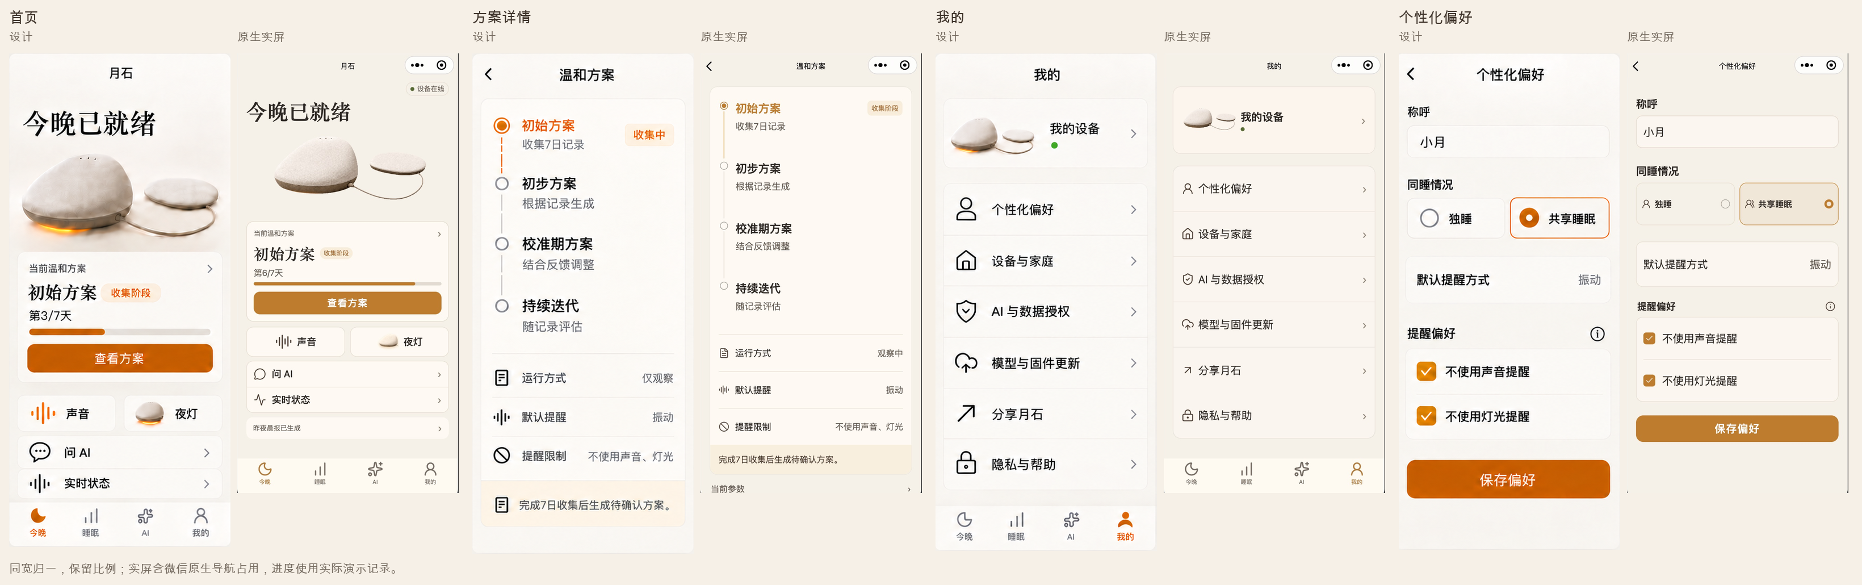
validation/ui-20261028/design-comparison-approved.png
