Evan0825/feldspar/docs/materials/README.md

# 月石项目资料

| 资料 | 文件 |
| --- | --- |
| 产品概念 | [首页封面](product-cover.png) |
| 技术架构 | [云边端升级架构图](technical-architecture.png) |
| 结构爆炸图 | [内部结构与供电架构](exploded-view.png) |
| 宣传海报 | [暖白](poster-warm-white.png) · [黑色](poster-black.png) · [印刷出血版](poster-bleed.png) |
| 鼾声模型训练报告 | [下载 HTML](https://github.com/Evan0825/feldspar/releases/download/v6-prototype/snoring-model-training-report.html) · [查看源文件](snoring-model-training-report.html) |

架构图、爆炸图和海报记录项目早期方案。V6 结构与接线以 [V6 工程样机](../../hardware/v6/README.md) 为准。训练报告中的 v5 是研究模型版本，尚未集成到 V6 公开固件。

本目录的原创封面、架构图、爆炸图、宣传海报及训练报告采用 [CC BY-NC 4.0](LICENSE)。高校和实验室可免费用于非商业教学与研究。分享或改编时请注明「月石 Feldspar 项目贡献者」、附许可链接并标明修改。用于商业推广、付费服务或产品交付时，请[联系项目维护者](https://github.com/Evan0825/feldspar/issues/new)取得授权。商标、第三方服务、数据集和模型权重沿用各自权利与许可。
