Evan0825/feldspar/hardware/v6/stl/moonstone_v6_upper.stl

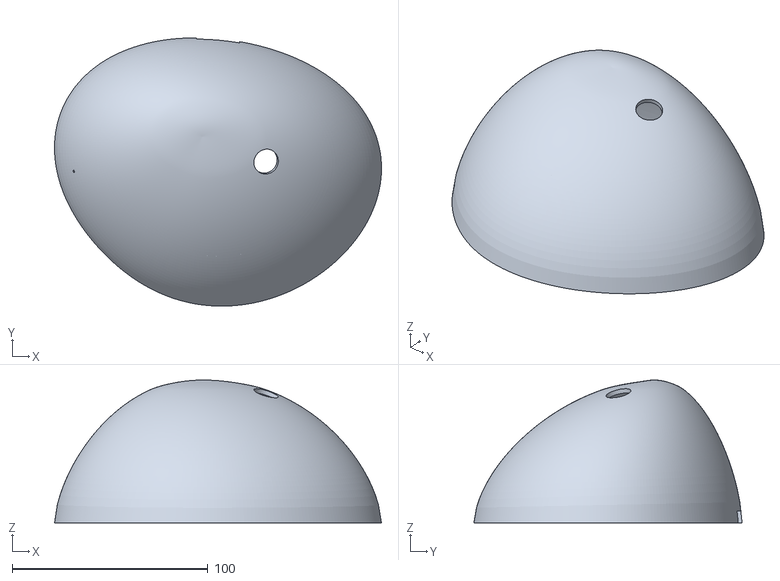
[picture p17: CAD file, 2026-11-12]
hardware/v6/stl/moonstone_v6_upper.stl
167.0 x 137.0 x 73.0
