Evan0825/feldspar/hardware/v6/stl/moonstone_v6_base.stl

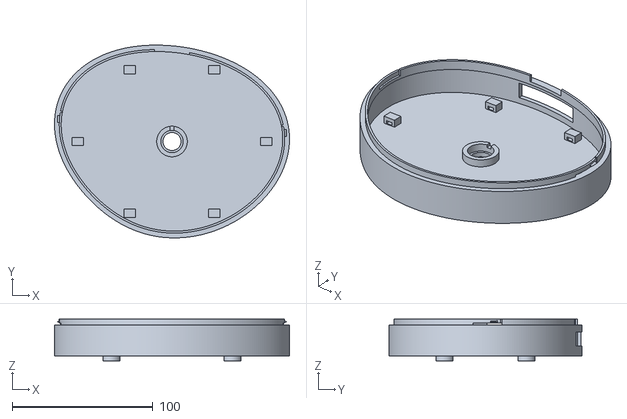
[picture p18: CAD file, 2026-11-12]
hardware/v6/stl/moonstone_v6_base.stl
167.0 x 137.0 x 29.5
