Evan0825/feldspar/hardware/v4/reference/snoozmate_refined_v4_final_preview_shell_REFERENCE_ONLY.stl

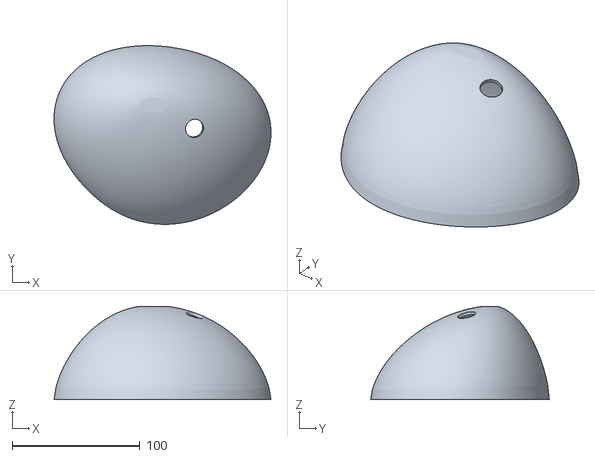
[picture p19: CAD file, 2026-11-12, an earlier design]
hardware/v4/reference/snoozmate_refined_v4_final_preview_shell_REFERENCE_ONLY.stl
170.0 x 140.0 x 73.0
