Evan0825/feldspar/hardware/v4/reference/snoozmate_refined_v4_final_button_cap_REFERENCE_ONLY.stl

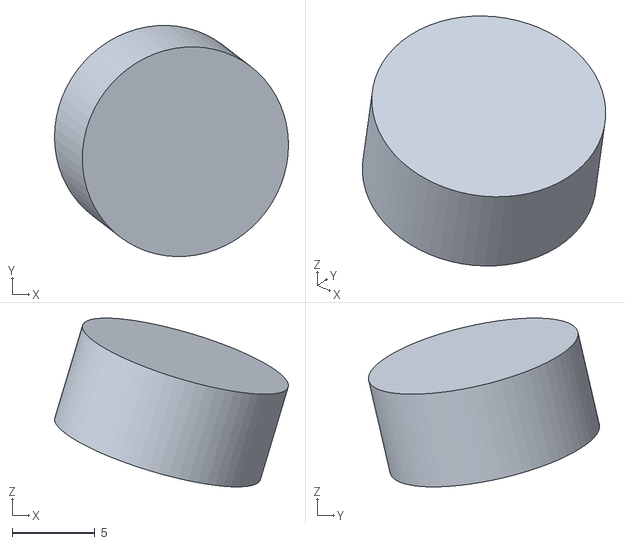
[picture p20: CAD file, 2026-11-12, an earlier design]
hardware/v4/reference/snoozmate_refined_v4_final_button_cap_REFERENCE_ONLY.stl
14.2 x 14.0 x 10.2
