Evan0825/feldspar/hardware/v4/stl/snoozmate_refined_v4_final_button_fit_gauge.stl

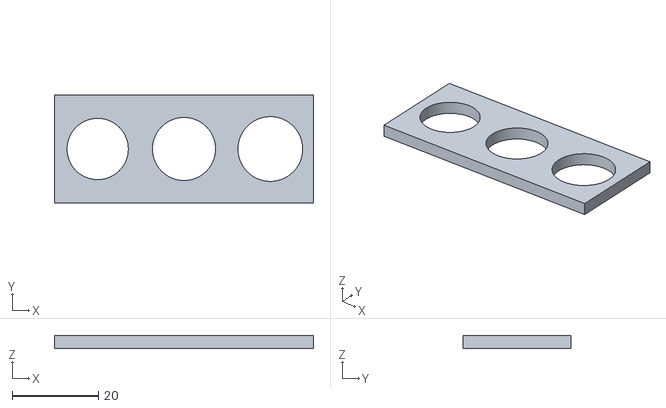
[picture p21: CAD file, 2026-11-12, an earlier design]
hardware/v4/stl/snoozmate_refined_v4_final_button_fit_gauge.stl
60.0 x 25.0 x 3.00
