Evan0825/feldspar/hardware/v4/stl/snoozmate_refined_v4_final_light_diffuser.stl

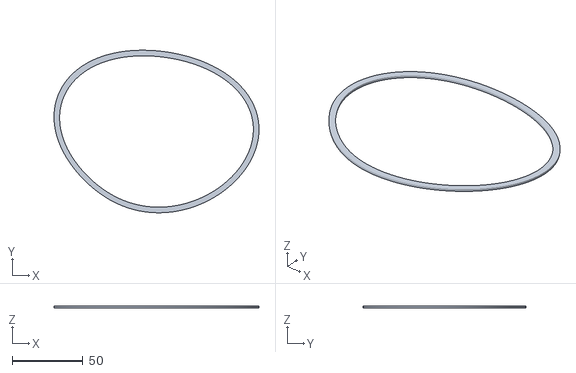
[picture p22: CAD file, 2026-11-12, an earlier design]
hardware/v4/stl/snoozmate_refined_v4_final_light_diffuser.stl
145.0 x 115.0 x 1.40
