Evan0825/feldspar/hardware/v4/stl/snoozmate_refined_v4_final_lower_base.stl

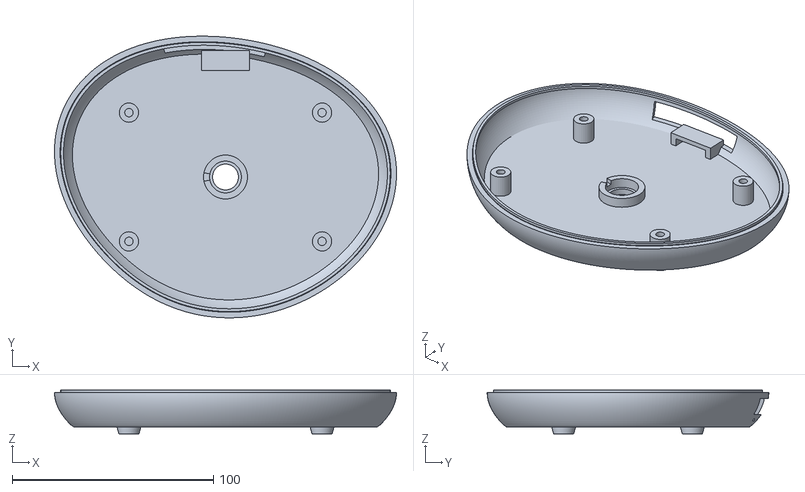
[picture p24: CAD file, 2026-11-12, an earlier design]
hardware/v4/stl/snoozmate_refined_v4_final_lower_base.stl
170.0 x 140.0 x 21.7
