Evan0825/feldspar/hardware/v4/stl/snoozmate_refined_v4_final_module_tray.stl

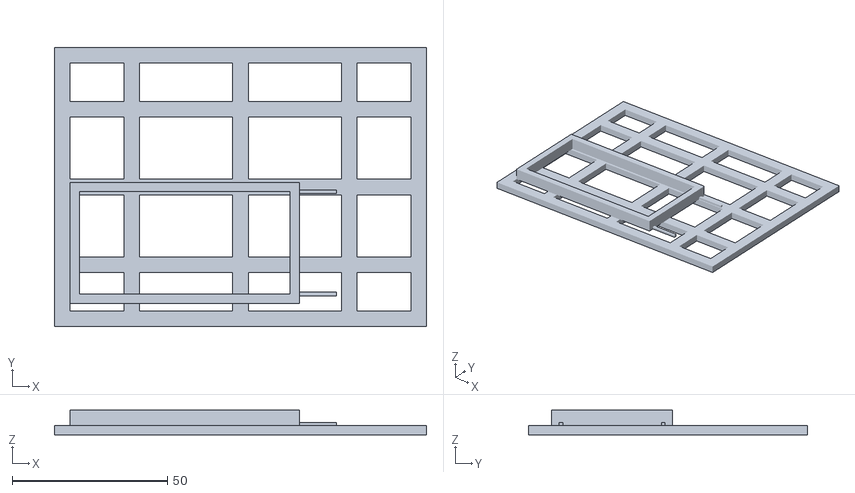
[picture p25: CAD file, 2026-11-12, an earlier design]
hardware/v4/stl/snoozmate_refined_v4_final_module_tray.stl
120.0 x 90.0 x 8.00
