Evan0825/feldspar/hardware/v4/stl/snoozmate_refined_v4_final_haptic_lower.stl

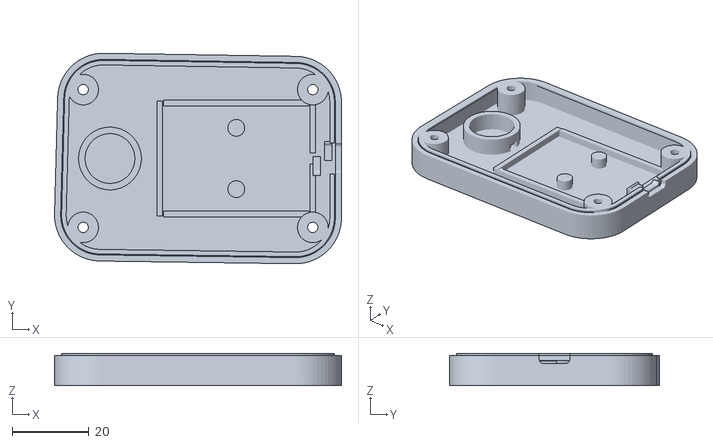
[picture p26: CAD file, 2026-11-12, an earlier design]
hardware/v4/stl/snoozmate_refined_v4_final_haptic_lower.stl
75.0 x 55.0 x 8.40
