Evan0825/feldspar/hardware/v4/stl/snoozmate_refined_v4_final_rear_interface_insert.stl

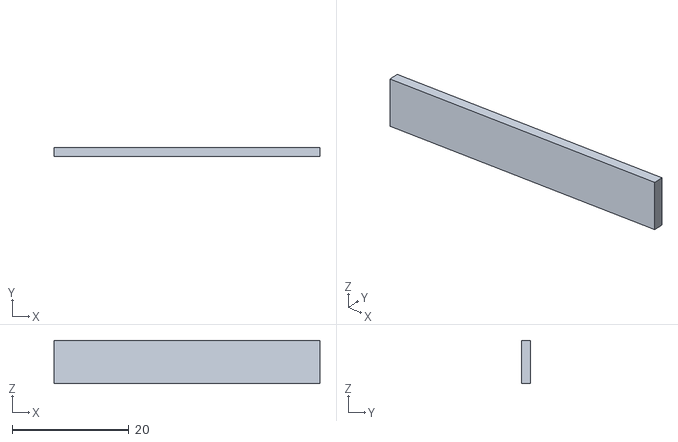
[picture p27: CAD file, 2026-11-12, an earlier design]
hardware/v4/stl/snoozmate_refined_v4_final_rear_interface_insert.stl
45.6 x 1.60 x 7.40
