Evan0825/feldspar/(list of files, cad)

Other CAD files:
hardware/v4/stl/snoozmate_refined_v4_final_upper_shell.stl
