Evan0825/feldspar/hardware/v6/ASSEMBLY.md

# V6 打印与装配

| 打印件 | 数量 | 尺寸 |
| --- | --- | --- |
| [上盖](stl/moonstone_v6_upper.stl) | 1 | 167 × 137 × 73 mm |
| [底座](stl/moonstone_v6_base.stl) | 1 | 167 × 137 × 29.5 mm，含定位边及脚托 |

按毫米、100% 比例切片。建议 PETG、0.4 mm 喷嘴、0.20 mm 层高、4 道壁、5 层顶底和 15–20% 填充。上盖开口朝下，底座脚托朝下。为上盖内侧曲面、底板悬空处和卡舌下方添加可清理的支撑。

1. 清理卡舌下方 1.2 mm 间隙和末端 1.0 mm 分隔槽。先空合上盖与底座，确认卡舌能轻微向内弹动。若闭合需要明显用力，检查残余支撑、首层外扩和定位边。
2. 按键对准顶部 Ø13 mm 开孔。麦克风声学入口对准侧面 Ø1.3 mm 开孔。按键板和麦克风胶粘固定，保持按键自由回弹和声孔畅通。
3. 按[接线与物料](WIRING.md)安装底部扬声器和各模块。底板留有胶粘区和六处理线孔，线束避开卡舌和定位边，从底座后侧走线。核对胶层、插头和弯线余量。
4. 对齐后侧开盖缺口与出线口，垂直放下上盖，轻压两侧扣合。开盖时托住底座，从后侧缺口抬起上盖，再依次松开两侧。给上盖线束留出拆盖余量。

V6 的底部环形出光口为封闭结构。卡扣力度和反复拆装寿命以首件实测为准。
