Evan0825/feldspar/hardware/v6/WIRING.md

# V6 工程样机接线与物料

本表按随附 ESP32-S3 固件的 GPIO 和已有模块资料整理，供开发板台架搭建使用。V6 的机械安装尺寸见 [打印与装配](ASSEMBLY.md)。开发板、扬声器和驱动板有多个型号，选购前实测外形与插线空间。能在台架上接通的替代件也可能装不进 V6 外壳。

| 数量 | 部件或选型 | ESP32-S3 接线 | 供电与核对事项 |
| --- | --- | --- | --- |
| 1 | ESP32-S3 开发板，建议 8 MB Flash、8 MB PSRAM 并引出下列 GPIO | USB 用于串口调试，默认 `115200` | 供电入口按开发板说明，选型时核对板宽、板长和插头余量 |
| 1 | INMP441 或等效 I²S 麦克风模块 | `BCLK/SCK → GPIO15`，`WS → GPIO16`，`SD/DOUT → GPIO17`，`L/R → GND` 选左声道 | `3.3 V`，16 kHz，声孔对准开口 |
| 1 | W25Q64JV 或等效 8 MB SPI NOR 模块 | `CS → GPIO9`，`CLK → GPIO10`，`MOSI/DI → GPIO11`，`MISO/DO → GPIO12` | `3.3 V`，固件预期 JEDEC `0xEF4017` |
| 各 1 | MAX98357A 或等效 I²S 功放、与功放匹配的小扬声器 | `BCLK → GPIO21`，`LRC/WS → GPIO14`，`DIN → GPIO13`，扬声器接功放 `OUT+` 和 `OUT−` | 台架参考 `5 V` 功放供电，扬声器参数按实际型号核对。扬声器座按 `Ø15.8 mm` 内径设计，实测扬声器尺寸和振膜余量 |
| 1 段 | WS2812B 或兼容 RGB 灯带，参考 10 颗、GRB | `GPIO8 → DIN`，核对信号方向，需要时使用合适的逻辑电平转换 | `5 V`，台架可接选配灯带，核对峰值电流 |
| 1 | [DFRobot DFR0029-W](https://wiki.dfrobot.com/dfr0029-w/) 或适配的瞬时按键 | 数字信号接 `GPIO7`。按下拉低使用固件默认配置。实际按下为高、空闲为低时启用 `CONFIG_FELDSPAR_BUTTON_ACTIVE_HIGH` | 模块建议 `3.3 V` 供电，先测实际极性和回弹，再装入上壳 |
| 各 1 | ERM 振动马达及匹配的驱动模块 | `GPIO42 → 驱动信号输入`。固件输出约 `20 kHz` 高有效 PWM，零占空比为停止。马达接驱动输出 | 按驱动和马达额定值供电，先核对针序、启动电流、温升与断电停止。GPIO 只传信号 |
| 按需 | 可限流电源、共地线、线束、绑线、固定胶与缓冲片 | 控制信号两端需要共同地参考 | 台架可用 `5 V / 2 A` 电源起步，按实测压降、负载和模块额定值调整 |

先断电核对针序、地线导通和供电入口，再上电逐模块确认空闲状态。主机短按切灯，长按约 2 秒全停并锁定。枕下振动以设备回读和实物启停共同确认。公开固件的自动提醒关闭。网络、微信和后端配置见 [软件复现说明](../../docs/REPRODUCE.md)。
