Evan0825/feldspar/hardware/v4/ASSEMBLY.md

# 好眠 SnoozMate｜精致月石 V4 顶部按键最终版

这是针对 DFRobot DFR0029 白色数字大按键的最终打印版。按键位于上壳顶部右侧，避开中部麦克风区，躺下或伸手时都比背部方案更好按。

## 打印件清单

1. `snoozmate_refined_v4_final_upper_shell.stl`：顶部按键孔、两个内侧正圆盲孔固定柱。
2. `snoozmate_refined_v4_final_lower_base.stl`：17 mm 薄底座、与上盖齐边的合盖边、内插定位边、Ø15.8 × 4.8 mm 底部喇叭仓、四个 3.5 mm 声学脚托、隐藏光缝与后侧电源线扣。
3. `snoozmate_refined_v4_final_module_tray.stl`：120 × 90 mm 模组托盘，总控板包络 68 × 33 × 20 mm。
4. `snoozmate_refined_v4_final_light_diffuser.stl`：145 × 115 mm 悬浮柔光环。
5. `snoozmate_refined_v4_final_rear_interface_insert.stl`：带全向装配余量的后接口空白嵌片。
6. `snoozmate_refined_v4_final_button_fit_gauge.stl`：按键试孔片，从左到右为 14.2 / 14.6 / 15.0 mm。
7. `snoozmate_refined_v4_final_haptic_lower.stl`：枕下震动模块下壳，包含驱动板定位、Ø13 × 5 mm 马达仓、走线槽、防拉扯肋和四个沉入式 M2.5 合盖孔。
8. `snoozmate_refined_v4_final_haptic_lid.stl`：枕下震动模块圆润上盖，组装后总包络 75 × 55 × 14 mm。

`snoozmate_refined_v4_final_button_cap_REFERENCE_ONLY.stl` 只用于预览白色帽体，不需打印。

## 公差和预留

| 位置 | 实物/标称尺寸 | CAD 预留 | 装配余量 |
| --- | ---: | ---: | ---: |
| 白色按键帽 | 约 Ø13.0 mm | Ø14.6 mm 贯穿孔 | 直径 +1.6 mm，单边 +0.8 mm |
| DFR0029 板 | 30 × 22 mm | 32 × 24 × 20 mm 保留区 | XY 单边 +1.0 mm |
| 按键板固定 | 两个 M2.5 位 | 内侧 Ø7.6 mm 正圆柱，自由端 R0.8 mm、内壁根部 R3.2 mm 圆角，根部 Ø14 mm，Ø3.4 mm 热熔螺母盲孔 | 盲孔直径含装配余量 |
| 底部喇叭 | Ø14.8 × 3.8 mm | Ø15.8 × 4.8 mm 安装仓 | 径向单边 +0.5 mm，高度 +1.0 mm |
| 喇叭出声与出线 | 底部出声 | Ø12.8 mm 出声孔 + 3 × 2 mm 上部出线缺口 | 四周约 1.0 mm 承托边 |
| 声学脚托 | 底部四点支撑 | 顶部 Ø12 / 底部 Ø10 × 高 3.5 mm | 喇叭孔离桌约 3.5 mm，柔光环最低处离桌约 1.3 mm |
| 总控板 | 63.4 × 28.3 × 5.2 mm | 68 × 33 × 20 mm 保留区 | 长度单边 +2.3 mm，宽度单边 +2.35 mm |
| 后接口嵌片 | 开口约 46 × 1.8 × 8 mm | 45.6 × 1.6 × 7.4 mm | 宽/深单边 0.2 mm，高单边 0.3 mm |
| 柔光环 | 底面 151 × 121 mm | 145 × 115 mm | 每边 3.0 mm |
| 上壳/底座对位 | 上盖外形 170 × 140 mm | 底座上沿 170 × 140 mm + 163.8 × 133.8 mm 内插定位边 | 定位边相对上盖内腔单边约 0.7 mm |
| 月石到枕下垫片电源线 | 按实物线径复核 | 后侧 24 × 10 × 2.2 mm 压线桥 + 双侧支撑，桥下可走线 | 建议用于 2–4 芯软线，装配时保留弯折余量 |
| 枕下震动外壳 | — | 75 × 55 × 14 mm | 圆润双件外壳 |
| 白色震动驱动模块 | 约 24 × 35 × 10 mm | 38 × 27 × 10.8 mm 保留区 | XY 单边至少 1.5 mm，高度合计 +0.8 mm |
| 驱动板定位孔 | Ø4.8 mm，孔距 16 mm | Ø4.4 mm 圆头定位柱，孔距 16 mm | 直径间隙 0.4 mm |
| 硬币震动马达 | 假定 Ø10–12 mm、厚度不超过 4.5 mm | Ø13 × 5 mm 马达仓 | 径向至少 0.5 mm，高度至少 0.5 mm |
| 枕下模块走线 | — | 3 × 2 mm 走线槽、8 × 4 mm 合盖出线口 | 转弯 R2，出线口内缘 R1 |
| 枕下模块止口 | 双件装配 | 单边 0.25 mm | 先试合，再锁紧四颗 M2.5 螺丝 |

卖家图只明确标出按键板约 30 × 22 mm，批次差和打印机收缩率仍可能不同。因此务必先打印试孔片，再打上壳。

## 建议打印参数

- 材料：外壳优先 PLA/PLA+，柔光环用半透明乳白 PLA/PETG。
- 喷嘴：0.4 mm；层高：上壳 0.16–0.20 mm，其他件 0.20 mm。
- 壁数：4；顶/底层：5；填充：15–20% Gyroid。
- 上壳：开口朝下放置，建议树状支撑，支撑仅接触打印板。
- 底座：脚托朝下放置，在四脚之间的底板下方启用树状/有机支撑，支撑仅接触打印板；打印后清理Ø12.8 出声孔。
- 托盘、嵌片和试孔片：平放打印。
- 柔光环：平放，100% 填充或连续同心纹。
- 枕下模块下壳：底面朝下平放；建议 4 道壁、5 层顶底、20–25% Gyroid。
- 枕下模块上盖：外观面朝上、开口朝下；按切片预览仅添加接触平台的树状支撑。
- 尺寸缩放保持 100%，不要启用切片软件的自动缩放。

## 装配顺序

1. 先打印试孔片，用实物白色按键帽试插；以“能自由回弹、无明显晃动”为准。
2. 如 14.6 mm 合适，直接打印上壳；如必须用 14.2 或 15.0 mm，在切片软件中仅对上壳 XY 进行约 99.5% 或 100.5% 小幅校正，并重新确认接缝。
3. 从上壳内侧将 DFR0029 的白色按键帽对准顶孔，连接器朝底座方向。
4. 从上壳内侧，在两个正圆盲孔中热压 M2.5、外径约 3.5 mm 的热熔铜螺母，再用两颗 M2.5 螺丝固定按键板；固定柱不穿透外观面，不要过度拧紧。
5. 将 Ø14.8 × 3.8 mm 喇叭从底座内侧放入Ø15.8 安装仓，振膜朝向Ø12.8 出声孔，导线经 3 × 2 mm 缺口引出；可用 0.5 mm 泡棉胶环消除松动。
6. 安装 63.4 × 28.3 × 5.2 mm 总控板、灯带和其他线束，线束在插头后保留至少 2 mm 弯折余量。
7. 将月石主机给枕下震动垫片供电/控制的软线压入底座后侧线扣；线扣只负责固定线材、防拉扯，具体正负极和信号线请按实际驱动板标识接线。
8. 可在四个脚托底部粘 0.5–1.0 mm 防滑硅胶垫，减少桌面共振和滑动。
9. 先试装后接口嵌片和柔光环，确认底座内插定位边能顺利进入上盖内侧后再闭合上下壳；如打印机外扩明显，优先轻修底座定位边外侧，不修上盖外观面。

## 枕下震动模块装配

1. 先核对实物白色驱动模块：外形应不超过约 24 × 35 × 10 mm，两个安装孔应为 Ø4.8 mm、中心距 16 mm。尺寸不符时不要强压安装。
2. 将硬币马达用 0.5–1.0 mm 薄型硬质双面胶固定在下壳 Ø13 × 5 mm 圆仓内，马达平面紧贴底板以传递震动，导线放入 3 × 2 mm 走线槽。
3. 在驱动板下方铺 0.4 mm EVA/TPU 缓冲片，将两个 Ø4.4 mm 定位柱穿入安装孔；定位柱只定位，不胀紧、不顶弯驱动板。
4. 连接马达线和主机线，将对外线材放入 8 × 4 mm 合盖出线口并绕过两道错位防拉扯肋；完整插头无需穿过出线口。
5. 在上盖对应驱动板的位置贴 0.4 mm EVA/TPU 缓冲片。上下软垫、10 mm 驱动模块合计正好占用 10.8 mm 内部高度。
6. 短时通电检查震动和温升后断电，合上止口，交叉均匀锁紧四颗 M2.5 螺丝；螺丝头不得突出底面。
7. 首次使用应在无人压住时进行短时震动和温升测试。若模块、线材或外壳明显发热、出现异味、松动或异常声响，立即停止使用。

## 验证结果

- 8 个可打印 STL 均为闭合网格，异常边为 0。
- 加入 3.5 mm 脚托后，整机包络为 170 × 140 × 93.5 mm。
- 上壳拓扑检查为 1 个真实按键贯穿孔。
- 14.4 mm 数字探针通过 14.6 mm 顶孔。
- 底部喇叭仓已按实测 Ø14.8 × 3.8 mm 放大为 Ø15.8 × 4.8 mm，并保留出线缺口。
- 总控板已按实测 63.4 × 28.3 × 5.2 mm 放大为 68 × 33 × 20 mm 安装包络。
- 底座上沿已调整为 170 × 140 mm，与上盖外形对齐；新增 163.8 × 133.8 × 1.2 mm 内插定位边，给上盖内腔预留约 0.7 mm 单边装配余量。
- 底座后侧已增加主机到枕下震动垫片的电源/控制线扣，线扣顶部 24 × 10 × 2.2 mm，双侧支撑下方留走线空间。
- 四个脚托与内部四个承力柱对齐，底部出声孔不再贴桌。
- 白色按键帽的预览 STL 不在打印件数量内。
- 枕下模块上下壳分别为 75 × 55 × 8.4 mm 和 75 × 55 × 6.2 mm，按 0.6 mm 止口重叠后组装高度为 14 mm。
- 枕下模块使用 38 × 27 × 10.8 mm 驱动板保留区、Ø13 × 5 mm 马达仓、Ø4.4 / 16 mm 定位柱及 8 × 4 mm 出线口。
- 除本次重做的底座外，其余精致月石主机 STL 保持原批准哈希；底座已作为新版合盖/线扣件重新生成。
