Evan0825/feldspar/validation/ui-interaction-20261028/plan-manual.png

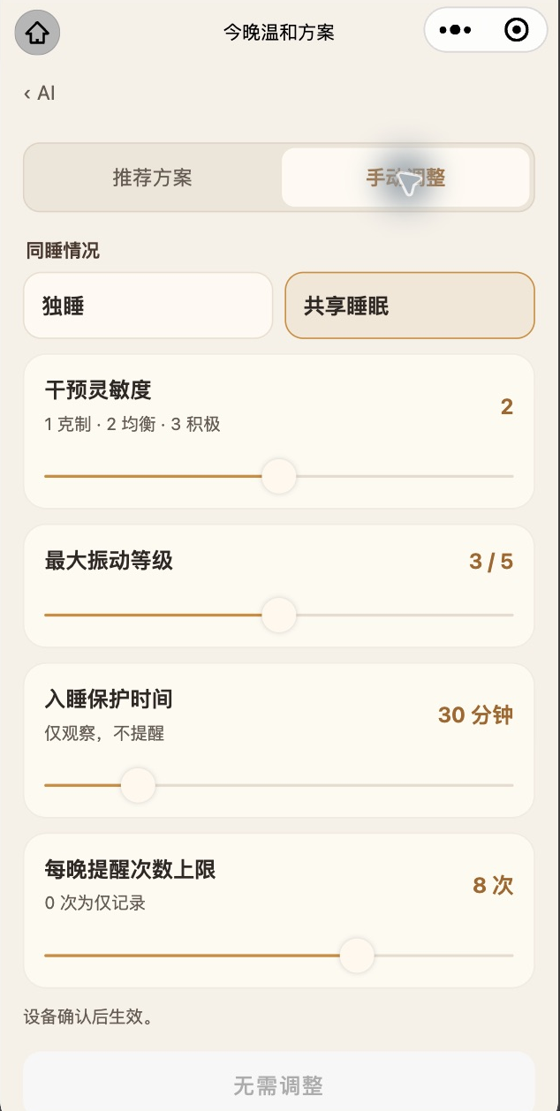
validation/ui-interaction-20261028/plan-manual.png
