Evan0825/feldspar/validation/ui-interaction-20261028/setup-wifi.png

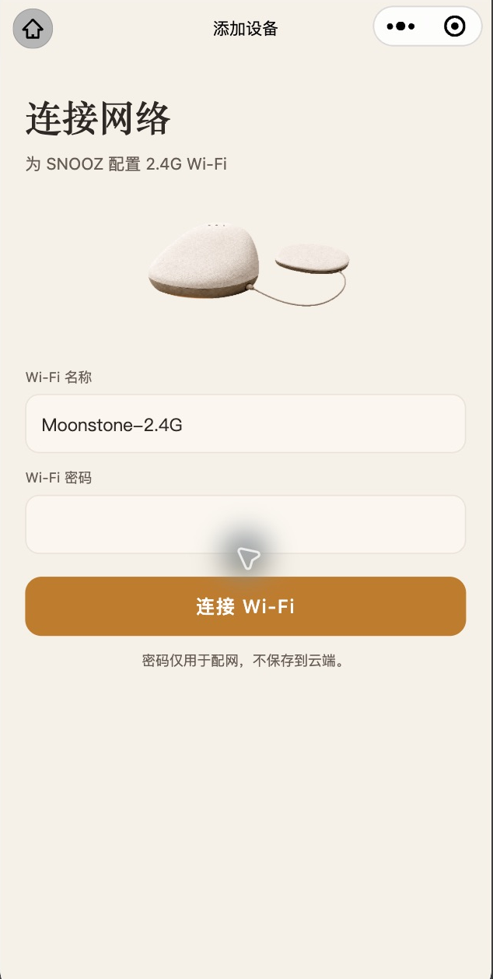
validation/ui-interaction-20261028/setup-wifi.png
