Evan0825/feldspar/validation/ui-20261028/01-home-first.png

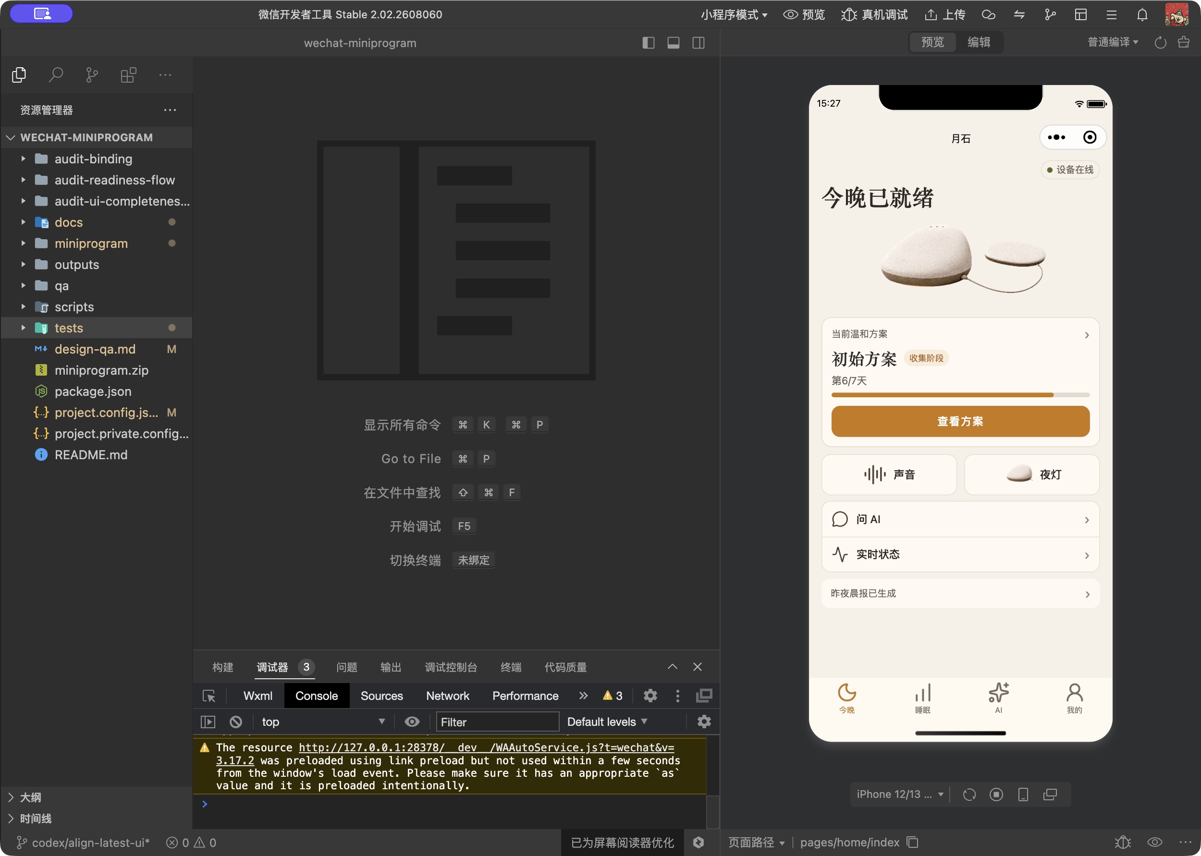
validation/ui-20261028/01-home-first.png
