Evan0825/feldspar/validation/ui-copy-20261028/ai-detail.png

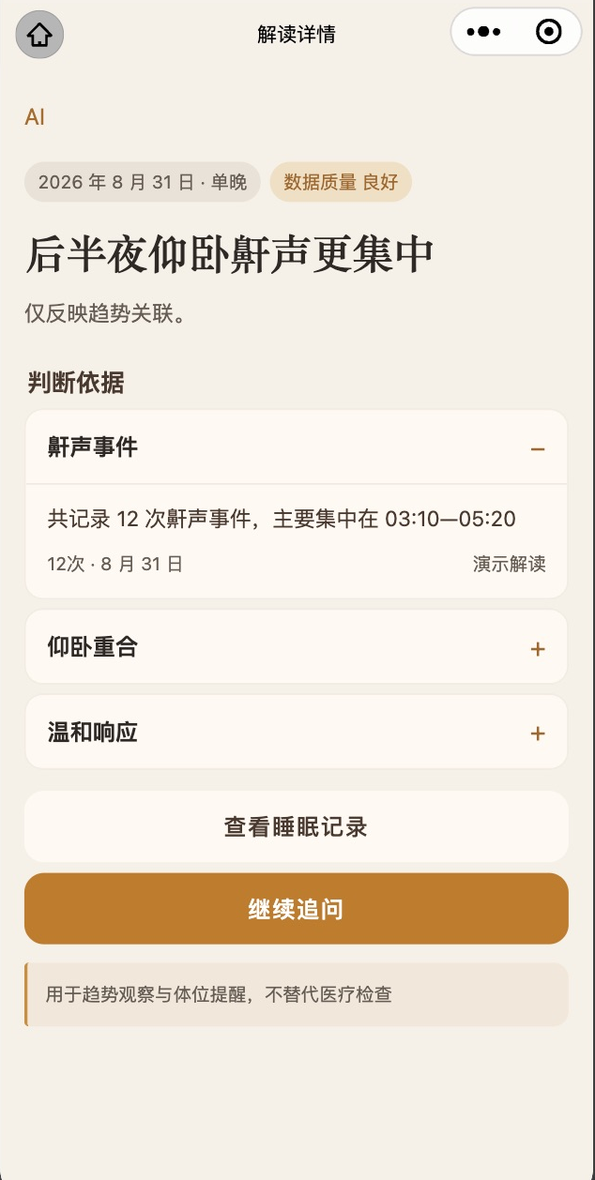
validation/ui-copy-20261028/ai-detail.png
