Evan0825/feldspar/validation/ui-copy-20261028/calibration.png

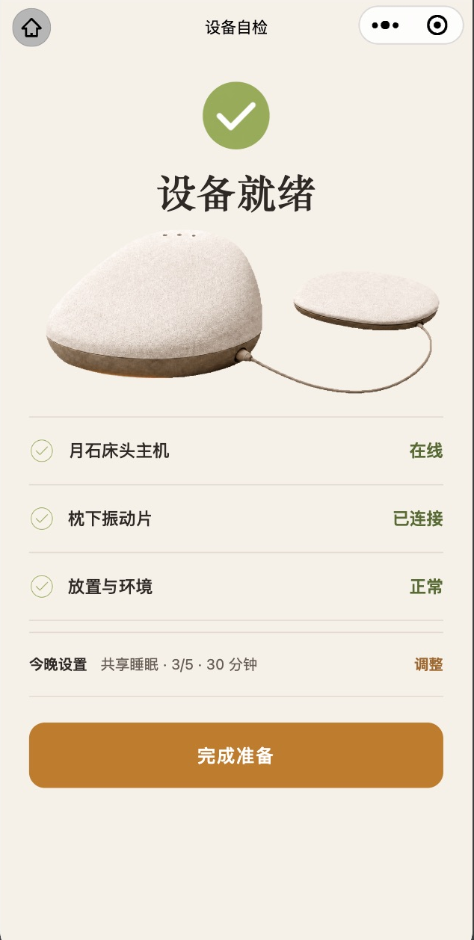
validation/ui-copy-20261028/calibration.png
