Evan0825/feldspar/validation/ui-copy-20261028/events.png

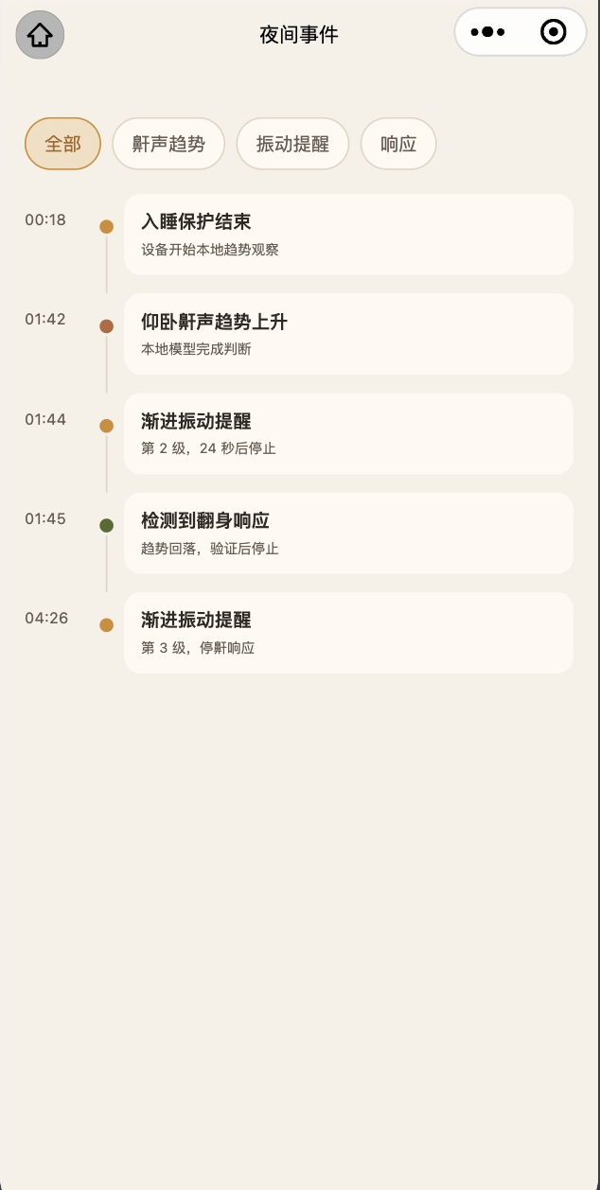
validation/ui-copy-20261028/events.png
