Evan0825/feldspar/validation/ui-copy-20261028/light.png

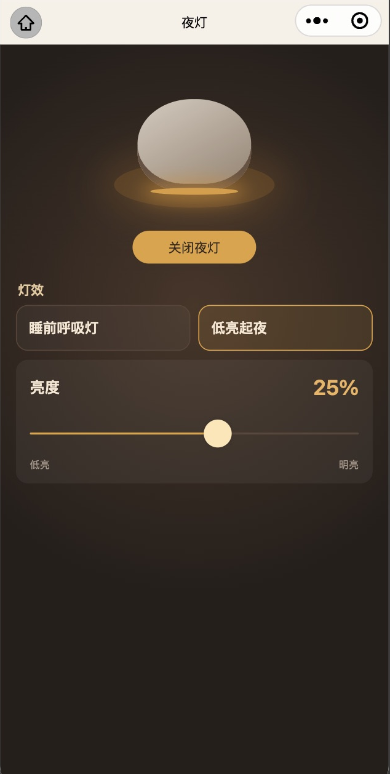
validation/ui-copy-20261028/light.png
