Evan0825/feldspar/validation/ui-copy-20261028/preferences-unchecked-reloaded.png

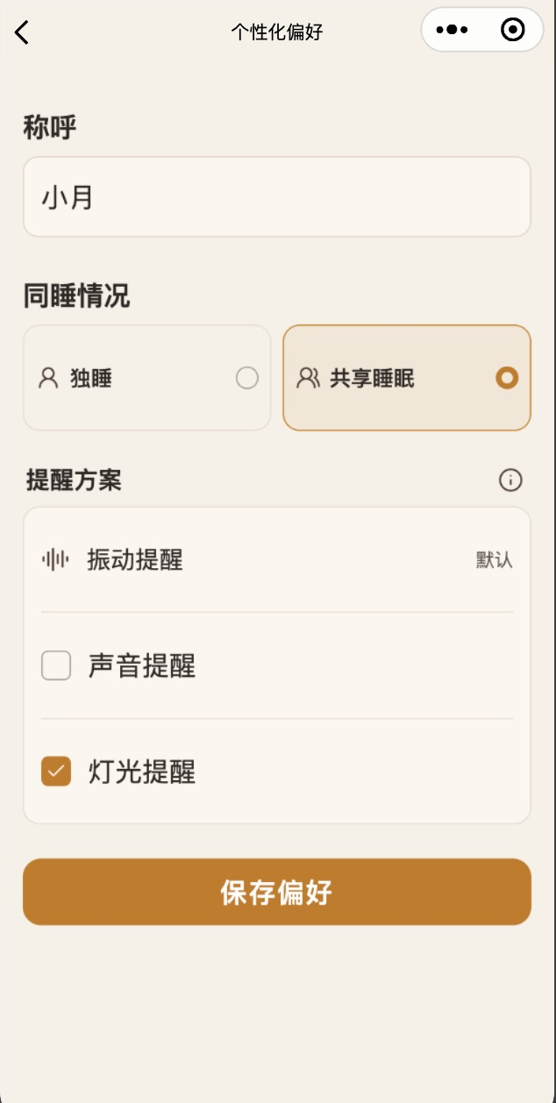
validation/ui-copy-20261028/preferences-unchecked-reloaded.png
