Evan0825/feldspar/validation/ui-copy-20261028/readiness.png

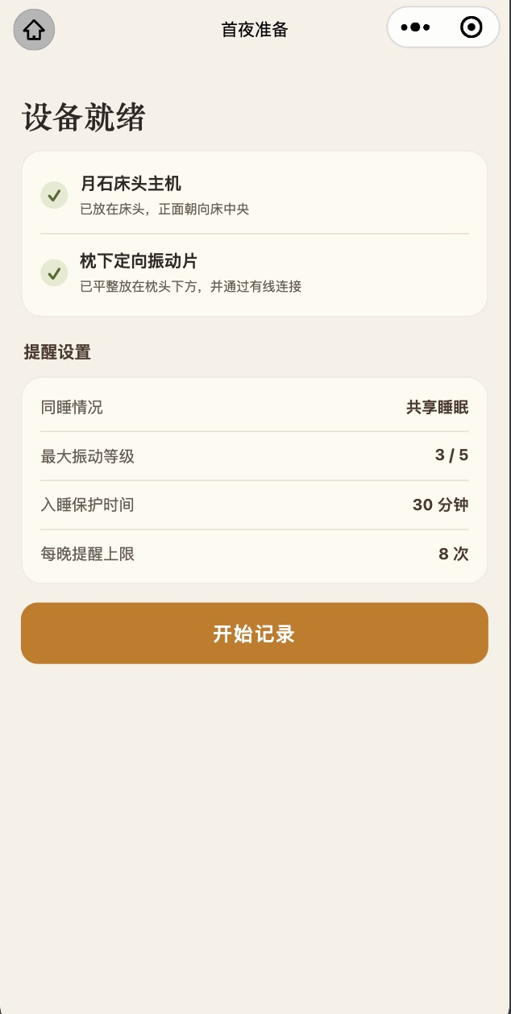
validation/ui-copy-20261028/readiness.png
