Evan0825/feldspar/validation/ui-copy-20261028/trends-bottom.png

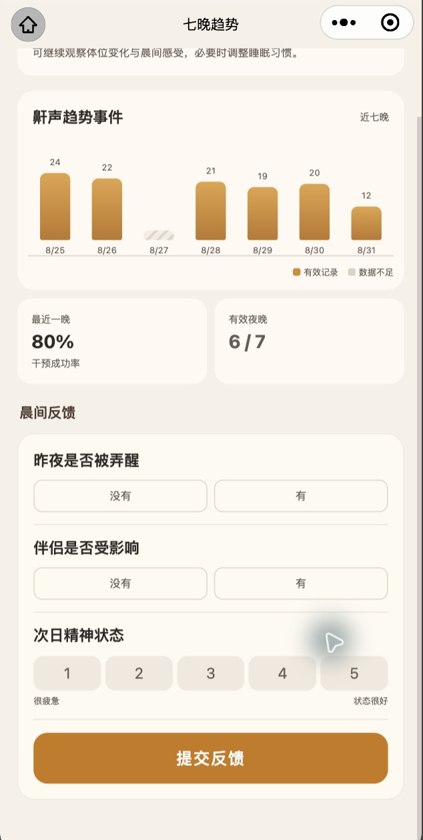
validation/ui-copy-20261028/trends-bottom.png
