Evan0825/feldspar/validation/ui-copy-20261028/月石-界面精简与提醒方案-实屏总览.png

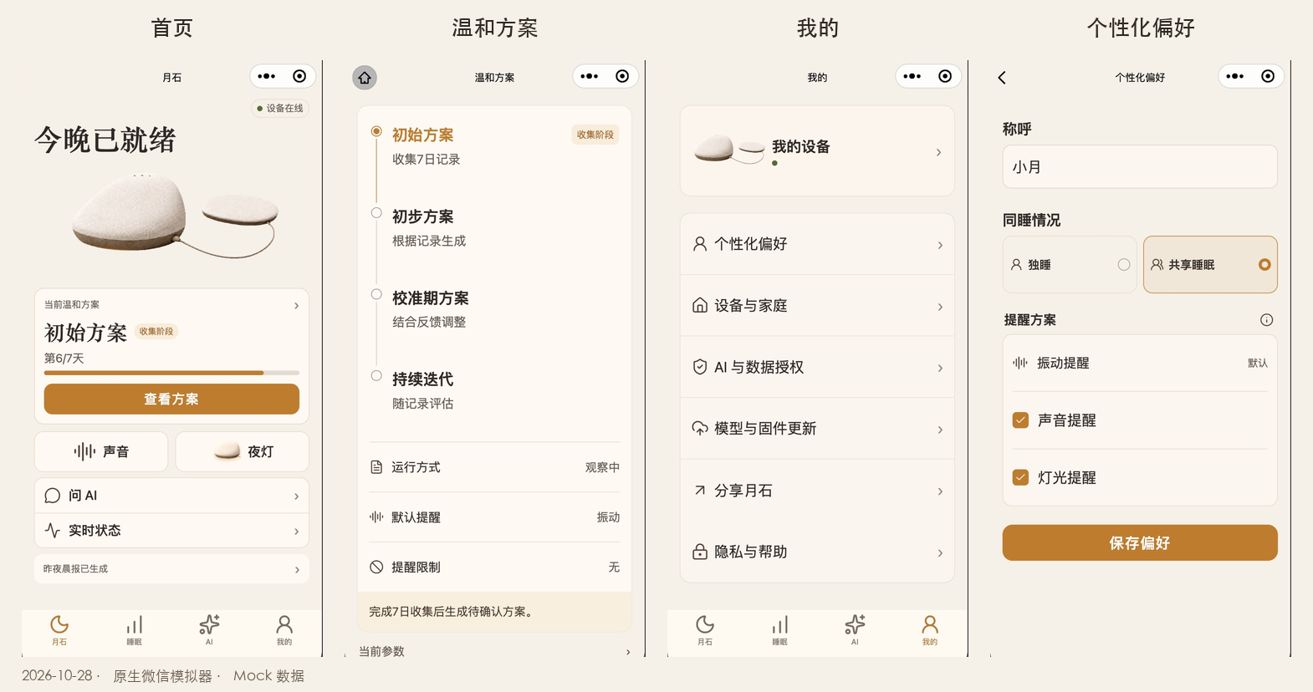
validation/ui-copy-20261028/月石-界面精简与提醒方案-实屏总览.png
