Evan0825/feldspar/validation/ui-interaction-20261028/01-sleep-night.png

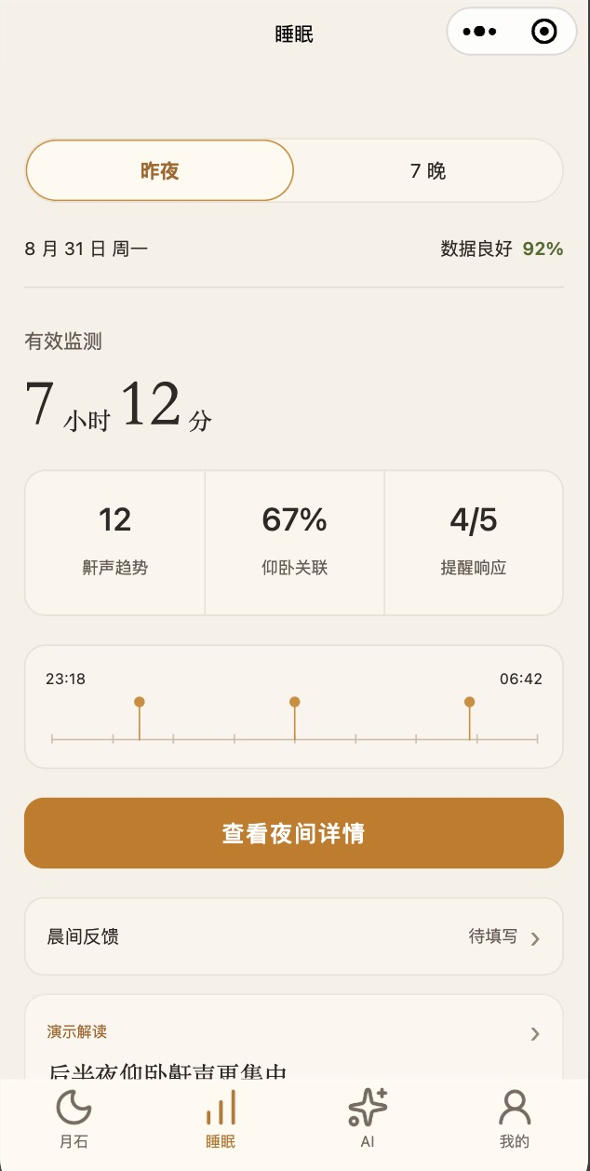
validation/ui-interaction-20261028/01-sleep-night.png
