Evan0825/feldspar/validation/ui-interaction-20261028/05-source-record.png

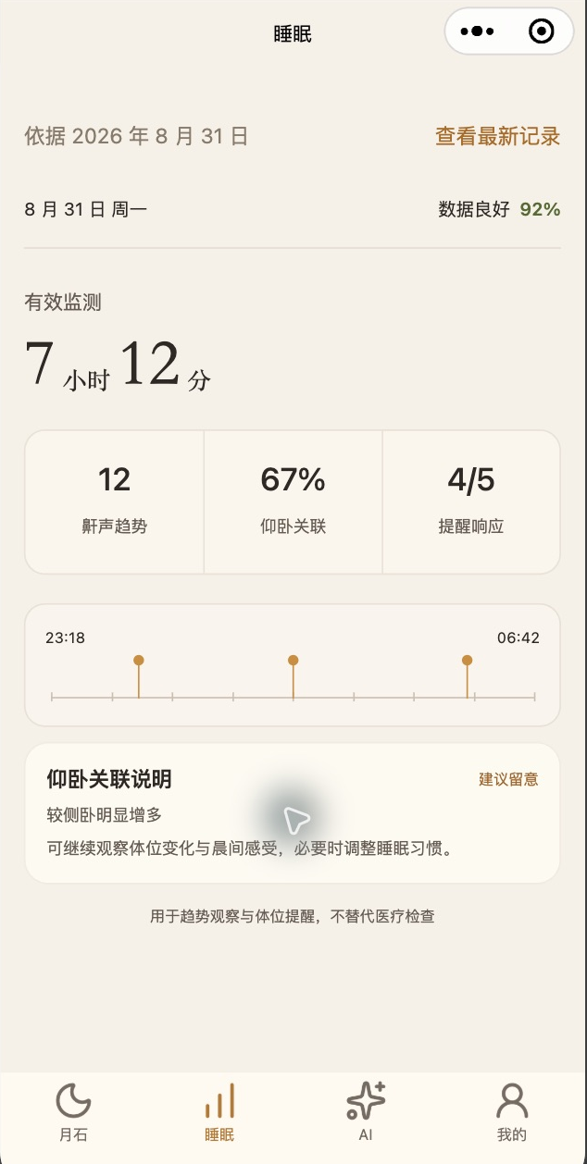
validation/ui-interaction-20261028/05-source-record.png
