Evan0825/feldspar/validation/ui-interaction-20261028/07-week-interpretation.png

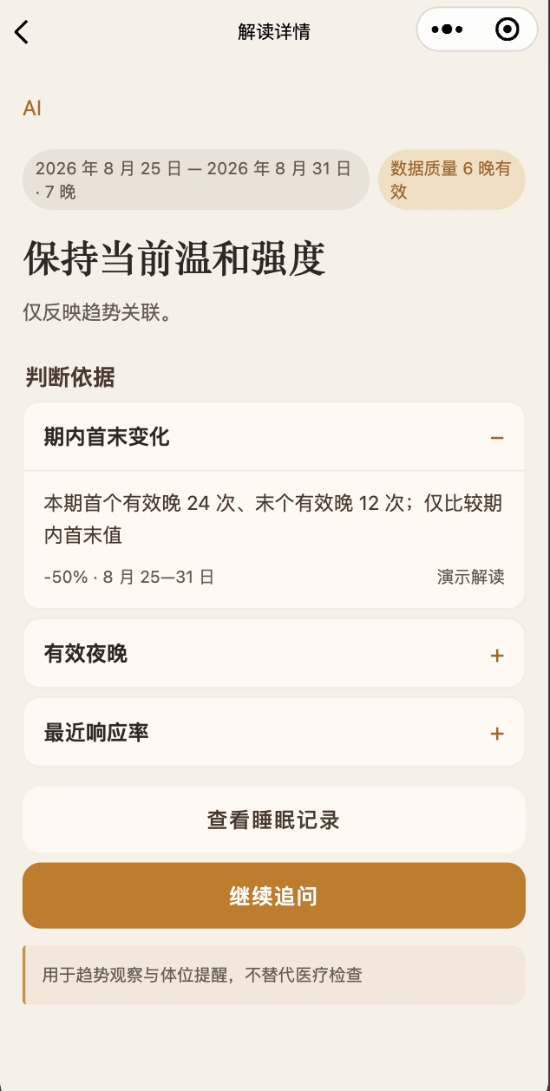
validation/ui-interaction-20261028/07-week-interpretation.png
