Evan0825/feldspar/validation/ui-interaction-20261028/10-ai-records.png

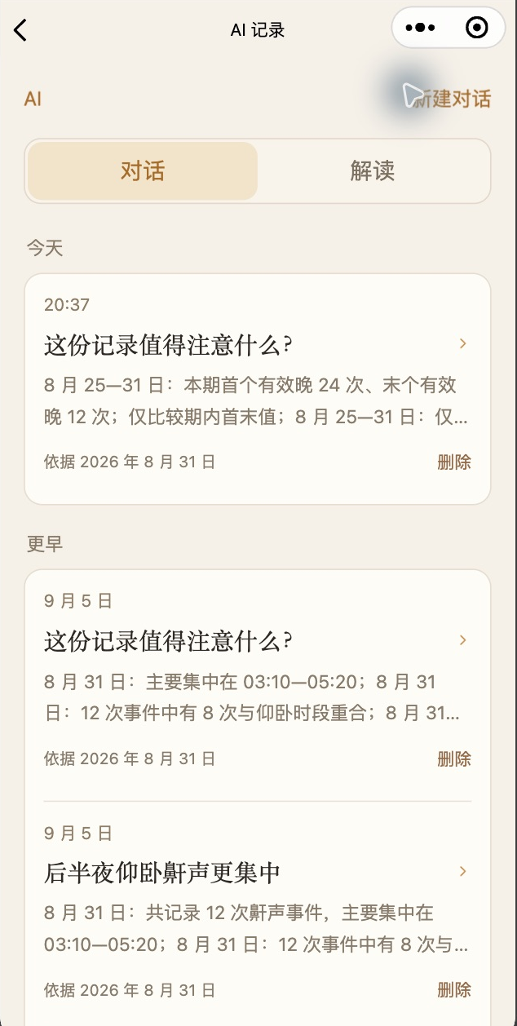
validation/ui-interaction-20261028/10-ai-records.png
