Evan0825/feldspar/validation/ui-interaction-20261028/14-feedback-focused.png

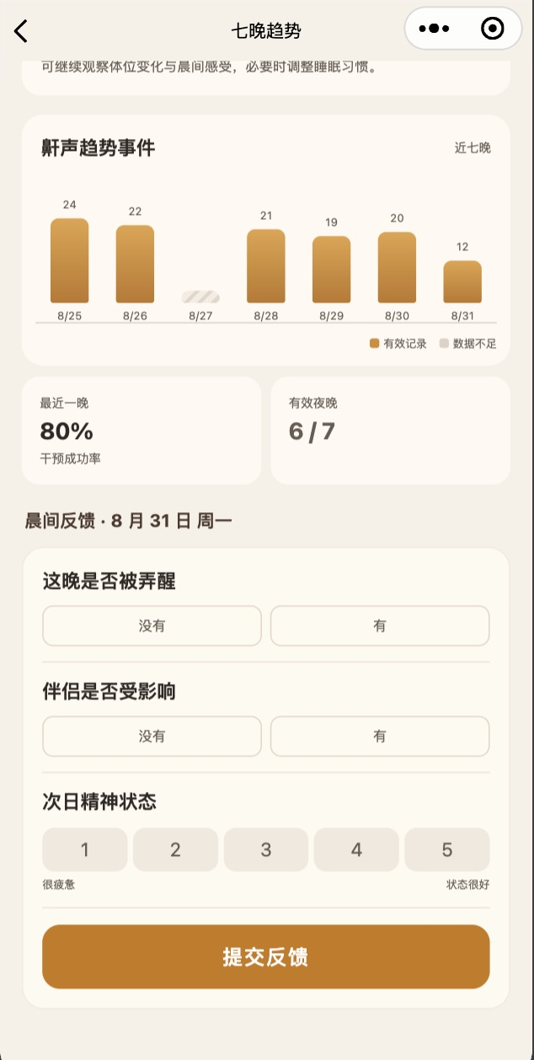
validation/ui-interaction-20261028/14-feedback-focused.png
