Evan0825/feldspar/validation/ui-interaction-20261028/19-chat-to-plan.png

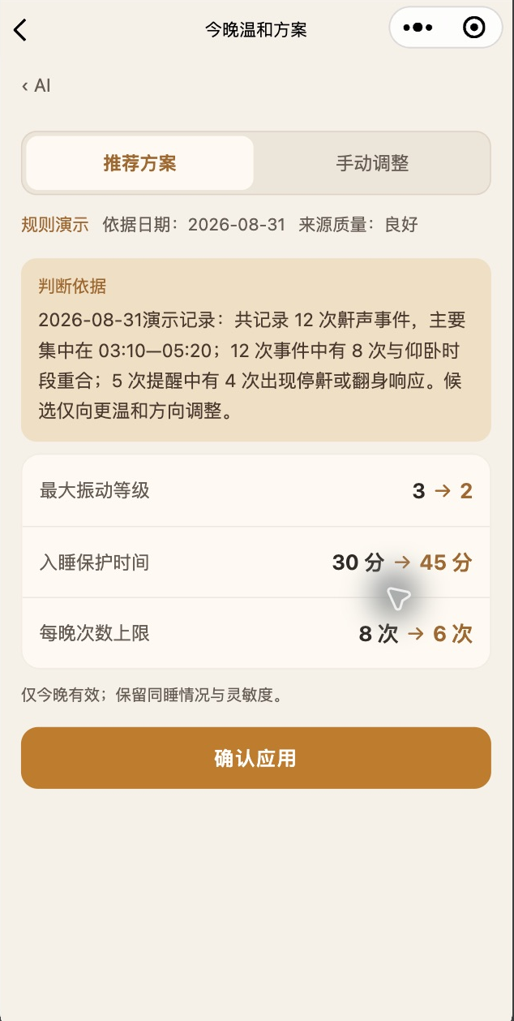
validation/ui-interaction-20261028/19-chat-to-plan.png
