Evan0825/feldspar/validation/ui-interaction-20261028/events-response.png

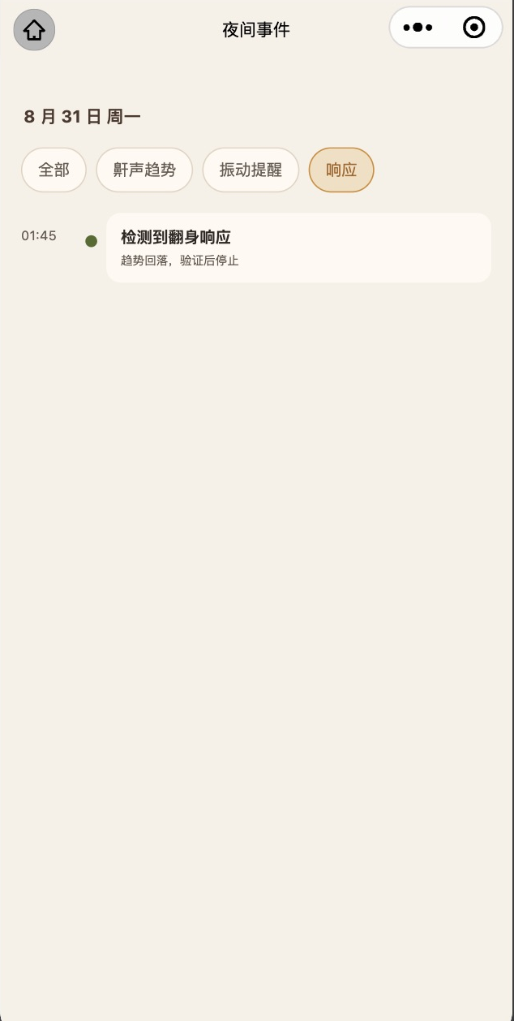
validation/ui-interaction-20261028/events-response.png
