Evan0825/feldspar/validation/ui-interaction-20261028/sound.png

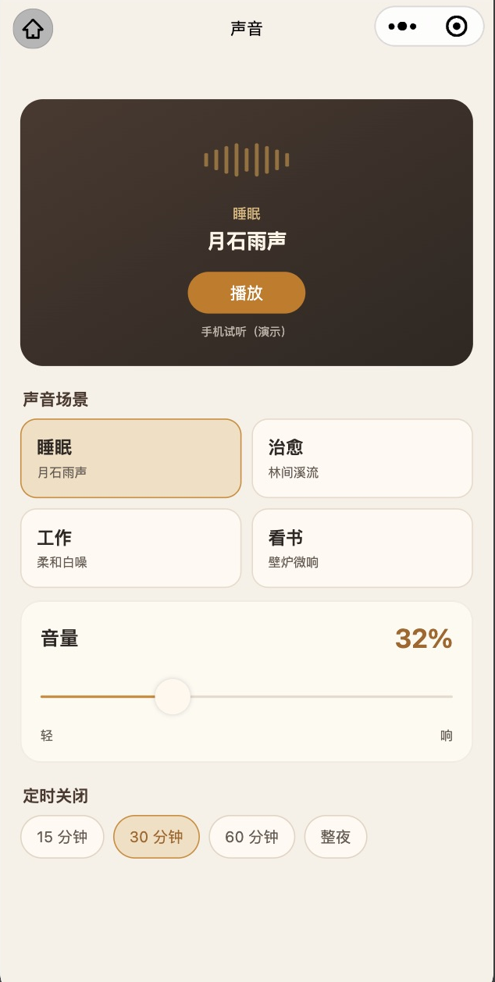
validation/ui-interaction-20261028/sound.png
