Evan0825/feldspar/validation/ui-interaction-20261028/月石-AI与睡眠数据-交互总览.png

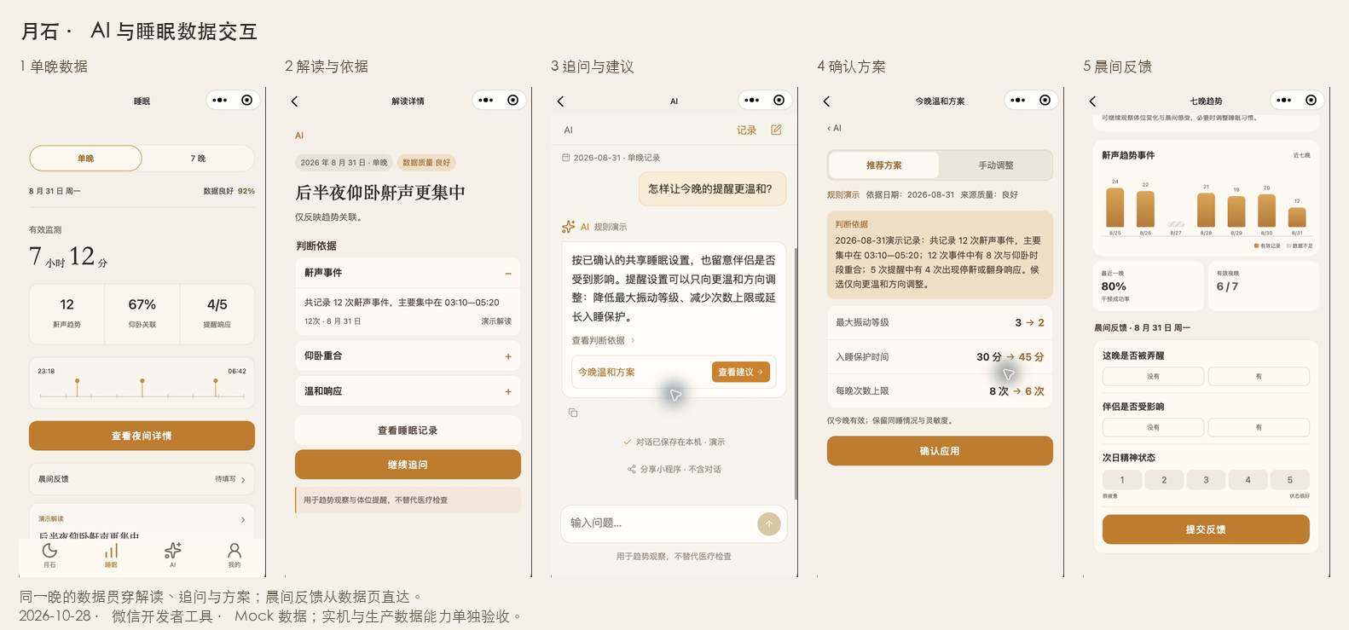
validation/ui-interaction-20261028/月石-AI与睡眠数据-交互总览.png
