Evan0825/feldspar/(commit log)

2026-11-09 Consolidate Moonstone UI, firmware and cloud integration
    Include native sleep and AI screens, device control and timer support, Ark model routing, and resilient MQTT audio ingestion. Remove unused backend code, share the BLE Base64 table, and keep public defaults isolated from test services.
2026-11-12 Publish Moonstone V4 prototype hardware
2026-11-12 Publish Moonstone V6 enclosure and reproducible CAD
2026-11-12 Require commercial permission for supplemental project materials
